ArpitAwasthi2411/slam-robot/hardware/datasheets/links.md

# Datasheets & references

- RPLiDAR A1: https://www.slamtec.com/en/Lidar/A1
- ESP32-S3: https://www.espressif.com/en/products/socs/esp32-s3
- BTS7960 driver: add the link for your module
