ArpitAwasthi2411/slam-robot/docs/navigation.md

# Navigation app: places, routes, missions, commands

Everything here runs on the Pi with **no internet and no Nav2 install**. It's built into the
`navigator` node, which `bringup.launch.py` starts by default (`nav_mode:=planner`).

Dashboard: route preview, queued mission, places

## The workflow (once encoder odometry is calibrated)

### 1. Map the floor once
```bash
ros2 launch lidar_robot bringup.launch.py
```
- Drive slowly around the whole floor with RC or the dashboard joystick, and come back to the
  start (loop closure).
- Dashboard → **Status → Save map**, name it e.g. `cse_floor`. You get:
  - `~/maps/cse_floor.pgm` + `.yaml`: an image of the map, which can also be used with Nav2's map_server
  - `~/maps/cse_floor.pbstream`: Cartographer's full state, needed for step 2

### 2. Every run after that: localise on the saved map
```bash
ros2 launch lidar_robot bringup.launch.py slam_mode:=localization map:=~/maps/cse_floor.pbstream
```
- Start the robot roughly where mapping started. Drive a metre or two.
- Check that the red scan points sit on the black walls of the map, then press **Position OK**.
  The navigator refuses to drive until you do: a wrong pose means a wrong route.
- Why this matters: a fresh mapping run starts a new map frame, so saved places would point at the
  wrong spots. Localization keeps the same frame every run.

### 3. Teach it places
- Drive to the HOD office door, then **Go → Places → Save here** and type `HOD office`, with
  aliases `hod, head of department`.
- Or **Add place** on the map: click the spot and drag to set the direction the robot should face.
- Places are saved in `~/maps/places.json` (one file per saved map; copy it next to the
  `.pbstream` when you back up the map).
- **Set home** marks the parking spot. "Go home" and the command "come back" drive there.

### 4. Use it
| You do | Robot does |
|---|---|
| Search "hod" → **Route** | Shows the planned route (amber), its length and ETA. Nothing moves yet |
| **Go** (on the route card or a place) | Plans an A* route around walls, follows it, turns to the place's heading |
| **Go here** tool, then click the map | Shows a route preview first, then **Go** |
| RViz **2D Goal Pose** | Same planner, so RViz goals now go around walls too |
| Type "urgent: take this to the HOD office then lab 3" | Parses the command, then queues a 2-stop mission at priority 3, which pauses the current normal one |
| Something blocks the corridor | Slows down, stops at 38 cm, waits 2 s, plans a new route around it (max 3 times), then fails with a reason |
| E-stop | Missions pause. After release they stay on **HOLD** until you press **Resume** |
| Touch the joystick or RC | Manual always wins, and the current mission is canceled |

## Commands: LLM with an offline fallback

- **With internet** (Pi on Wi-Fi): `export GROQ_API_KEY=gsk_...` before `ros2 launch`. The navigator
  sends the command plus the list of known places to Groq and gets back
  `{intent, targets, priority, reply}`.
- **Without internet, or if the LLM call fails**: a built-in rule parser handles
  "go to / take / deliver ... then ...", typos ("principl offce"), urgency words, "come back", "stop"
  and "where are you". The dashboard marks each answer **LLM** or **OFFLINE**.
- **Hallucination guard**: any place the LLM names that isn't on the map is dropped and reported,
  never driven to.

That fallback, plus the guard, is your answer to the ELLMER limitation ("cloud-dependent with no
fallback").

## Failure reasons (foundation for LLM error recovery)

Every failed mission records a code and a sentence, shown in the dashboard and the activity log:

| Code | Meaning | Typical recovery |
|---|---|---|
| `GOAL_IN_OBSTACLE` | target is inside a wall or furniture | move the place, or pick the nearest free spot |
| `OUTSIDE_MAP` | target outside the mapped area | map that area first |
| `NO_PATH` | no free route (door closed or unexplored) | try later, or another route/entrance |
| `BLOCKED` | something stayed in the way after 3 new routes | ask a human, wait, or skip the stop |
| `START_BLOCKED` | robot too close to an obstacle to plan | back off 30 cm |
| `POSE_LOST` | SLAM pose stale for over 3 s | stop, relocalize |
| `INTERNAL` | software error (logged with a traceback) | report |

Phase 7 idea: feed `{code, text, mission, places, time}` to the LLM and let it choose among a fixed set
of safe actions (retry later / skip stop / reorder stops / notify user / go home), each validated
before running. Same pattern as the command parser: the LLM proposes, the code checks.

## Request API (for the app, scripts, and your FastAPI server)

Send a JSON `std_msgs/String` to `/navigator/request`; replies arrive on `/navigator/response`. Over
HTTP, the dashboard forwards `POST /api/nav` with the same JSON.

```jsonc
{"type": "goto_place", "name": "HOD office", "priority": 1}
{"type": "goto_pose", "x": 3.2, "y": 1.0, "yaw": 1.57, "label": "lab door"}
{"type": "command", "text": "urgent take this to hod then lab 3"}
{"type": "preview", "name": "Lab 3"}             // route only, no motion
{"type": "cancel"}  {"type": "cancel", "id": 7}
{"type": "resume"}  {"type": "go_home"}  {"type": "confirm_localization"}
{"type": "add_place", "name": "Lab 3", "x": 2.2, "y": 1.8, "yaw": -1.57, "aliases": ["computer lab"]}
{"type": "add_place", "name": "Water cooler", "here": true}
{"type": "delete_place", "name": "Lab 3"}   {"type": "set_home", "here": true}
{"type": "search", "q": "hod"}
// routes, patrols and drawn paths (app map tools)
{"type": "goto_poses", "waypoints": [{"x": 1, "y": 2}, {"x": 3, "y": 2, "label": "door"}], "repeat": -1}  // -1 = patrol
{"type": "check_path", "points": [[0, 0], [1, 0.5], [2, 0.5]]}      // drawn path: length, ETA, too-close parts
{"type": "follow_path", "points": [[0, 0], [1, 0.5], [2, 0.5]], "repeat": 0, "allow_close": false}
// exploration (docs/exploration.md) and path-follower tuning (Tuning Lab)
{"type": "explore_start", "speed": 0.18, "turn_speed": 0.45, "scan_spin": true}   {"type": "explore_stop"}
{"type": "get_tune"}   {"type": "tune", "follower": {"lookahead": 0.5}, "save": true}
// rooms, dock, schedules, "wait for OK", explain, mission log: see "v2.4: tasks people actually ask for" below
{"type": "recovery_answer", "id": 3, "choice": "retry"}   // answer "ask a person" (docs/recovery.md)
```
The full list with every field is at the top of `lidar_robot/navigator_core.py`; which role may send which
type is `STAFF_NAV` in `lidar_robot/auth.py` (staff: go/call/stop/ask, operator: everything else).

Status (4 Hz, `/navigator/status`): state, message, goal, remaining route, distance, ETA, missions
(active, queue, history), recent events, hold, localized.

Command-line example:
```bash
ros2 topic pub --once /navigator/request std_msgs/msg/String '{data: "{\"type\": \"goto_place\", \"name\": \"Lab 3\"}"}'
ros2 topic echo /navigator/status --once
```

## Tuning (`config/robot_params.yaml` → `navigator:`)
| Param | Default | What it does |
|---|---|---|
| `robot_radius` | 0.27 m | keep-out radius. Your corridor is 0.88 m wide, so 0.88 − 2×0.27 leaves 0.34 m of usable centre line |
| `soft_radius` | 0.60 m | prefer this much clearance from walls (keeps to the corridor centre) |
| `max_linear` | 0.22 m/s | cruise speed |
| `stop_distance` | 0.38 m | front clearance from the robot centre that stops it (440 mm chassis) |
| `blocked_after` | 5 s | stopped by an obstacle this long → plan a route around it (people usually move by then) |
| `us_memory_s` | 60 s | an obstacle only the ultrasonics see (low box, chair legs: below the LiDAR plane) is kept on the plan this long. While the robot is blocked, and for 15 s while it goes round, every sensor's echoes are placed along that sensor's own ~30° beam (left / centre / right), so the obstacle lands on the side where it really is and the planner goes round the free side (log: `ultrasonic blocker on the right remembered`). Each echo is grown 0.3 m deep plus a 0.15 m berth; echoes on mapped walls are skipped (corridors stay usable); after 60 s it is forgotten so a moved box leaves no fake wall |
| `dwell_s` | 3 s | wait at intermediate stops |
| `auto_return_s` | 0 | above 0: drive home after this many idle seconds |
| `allow_unknown` | false | plan only through mapped free space |

## Try it without the robot
```bash
python3 tools/dashboard_sim.py      # simulated CSE floor, same navigator code
# open http://localhost:8080
```

## v2.4: the robot knows its own shape

The planner used to treat the robot as a 27 cm circle around the drive axle. Ours is a 44 × 42 cm
rectangle with the axle near the **front**, so the back (37 cm behind the axle) swung out on turns
and clipped walls. Now:

- **Measure and set** `footprint_front`, `footprint_rear`, `footprint_half_width` in
  `config/robot_params.yaml` (axle centre → front bumper, → back edge, centre line → side).
  The app draws exactly this rectangle, so check it lines up with the scan dots around the robot.
- **Planning:** every route is checked with the whole rectangle at every point and at every turn
  on the spot. If it clips, it tries a wider route (one that clears the full turning circle). If no
  wider route exists (a narrow door), it keeps the route but marks the tight spots (orange rings in
  the app) and drives them at 60 % speed.
- **Driving:** every 50 ms the live 360° scan is checked against the body:
  - a turn on the spot that would swing the back into something is refused; it turns the other way
    round if that is clear, otherwise it plans a short **3-point turn** (pull ahead / back out a few
    cm / turn) that ends facing the route;
  - on curves, if the body would touch something within 0.6 s it straightens or stops;
  - near anything (doors) it slows down in proportion to the gap.
- **Result in the simulator** (`python3 tools/eval_nav.py`, same layout as the sim, 12 missions incl.
  4 hard starts next to walls):

  | | reached | wall contacts | total time |
  |---|---|---|---|
  | old (circle robot) | 10 / 12 | 3 | 986 s |
  | v2.4 body checks | **12 / 12** | **0** | 582 s |

## v2.4: tasks people actually ask for

- **Wait for OK:** "take this file to the HOD office and wait for a signature, then Lab 2". At that
  stop the app shows a big **OK, carry on** card (and the robot says so). It carries on by itself
  after `confirm_timeout_s` (5 min). Saying "ok" / "done" by voice works too.
- **Rooms:** Room tool → drag a box over a room → name it and list what is in it. Then: "take me to
  the 3D printer", "where is the oscilloscope?", "go to the room with the soldering station".
  The robot drives to the room's centre, or to a saved place with the same name (put a place at
  the door for rooms with furniture in the middle). The app shows which room the robot is in.
- **Schedule:** Go tab → Schedule → Add: a place, home, charge or any command at a time, every
  day or chosen days. Uses the Pi's clock (set by NTP when it has internet; after a power cut
  without internet, set it once with `sudo date -s "2026-10-14 09:30"`).
- **Why did you stop?** Tap the state chip at the top right (or say "why did you stop?"). The
  answer comes from the navigator's own state and log: e-stop, waiting for OK, blocked in front,
  no room to turn, failure reasons, battery.
- **Mission log:** every finished mission is a line in `~/maps/missions.jsonl` (time, distance driven
  vs planned, replans, blocked time, bumps, e-stops, closest approach to anything). Lab → Log shows
  success rate, average time and speed, path efficiency; Export CSV for the report.
- **AI assistant access:** [mcp.md](mcp.md).

New request types (JSON on `/navigator/request` or `POST /api/nav`): `confirm`, `explain`, `find`,
`add_room`, `update_room`, `delete_room`, `goto_room`, `set_dock`, `go_dock`, `schedule_add`,
`schedule_delete`, `schedule_enable`, `schedule_list`, `mission_log`. See the top of
`navigator_core.py`.

## Error recovery (Phase 3)

When a step fails with a recoverable reason code the navigator no longer just marks the mission FAILED: it
stops (state `RECOVERING`), the LLM or the rule-based fallback picks one action from a fixed menu (wait and
retry, wider route, detour, skip the stop, do it later, ask a person, go home, go to the dock) and the robot
carries it out. `status()['recovery']` drives the app's "What happened / What I'm doing" card. Details,
settings and the evaluation: [recovery.md](recovery.md).

## Person or object in the way (`blockers.py`)

When the front is blocked the robot first decides what blocks it, using the people detector (the Pi camera,
or the mounted phone in head mode) together with the LiDAR / ultrasonic stop:

| In the way | How it knows | What it does |
|---|---|---|
| a person | the detector reports someone in the path within 2.5 m while the front is blocked | stops, says "Excuse me, may I pass?" once, waits `person_wait_s` (8 s). Way clear: "Thank you", continues. Still there: looks for another route |
| an object | fresh camera decisions, nobody in the path for `object_wait_s` (1.2 s) | says nothing, looks for another route at once (before: always waited `blocked_after`, 5 s) |
| unknown | no fresh camera decision (camera off, detector resting, no picture) | as before: asks to make way, replans after `blocked_after` |

- The decision is taken over about a second, not on one frame. A person seen once stays "a person" for that block.
- Wrong guesses are safe: the robot never drives through anything; it only chooses between waiting and going around.
- A camera STOP (person very close) still holds the robot by itself, as before.
- The app message, "Why did you stop?" and the head-mode face say which it is.
- Each trip in the mission log counts `blocked_person` and `blocked_object`; `/navigator/status` → `blocker`
  has the totals and the seconds lost to each, for the reliability table.
- Settings (navigator): `polite_pass` (false = old behaviour), `person_wait_s`, `object_wait_s`, `pass_text`
  (e.g. "Kripya raasta dijiye").

Not yet tried on the robot: check that the person check agrees with what you see (stand in the path: it must
ask; put a chair there: it must reroute without speaking).
