ArpitAwasthi2411/slam-robot/docs/REVIEW_2026-10.md

# Repo review, October 2026 (Phase 0)

Scope: firmware (3 sketches), ROS package (nodes + pure-Python logic), launch/config, the app and the classic
page, scripts, tools, docs and CI. Method: read the core modules (navigator_core, esp32_bridge, dashboard,
dashboard_server, auth, navigator, explain, mapsave, mcp_server), automated checks over everything
(pyflakes on all Python, `bash -n` + shellcheck on all scripts, YAML params vs. the parameters each node
declares/reads, every API path and navigator request type used by each client vs. what the server/core
implements, firmware `#define` pins vs. every pin table in the docs, test coverage per module), and ran the
tools (`dashboard_sim.py`, `eval_nav.py`, `eval_commands.py`, the MCP server against the simulator).

Tests: 112 → **126** (125 + 1 skip under the CI's Python 3.10 / pytest 6.2.5). Coverage of the pure-Python
logic 65 % → 71 %. The four ROS node wrappers (navigator, dashboard, goal_controller, us_listener) have no
unit tests: they are thin and need TF/rclpy; the bridge is covered end to end over a pseudo-terminal.

## Bugs fixed

| # | Where | What was wrong | Fix + test |
|---|---|---|---|
| 1 | `dashboard_server.py`, `dashboard.py`, `esp32_bridge.py` | `POST /api/cmd {"v": "nan"}` passed `float('nan')` through the `min/max` clamp (NaN compares false) into `/cmd_vel_teleop`. In the bridge's 20 Hz timer `format_velocity` does `int(round(nan))` → `ValueError` inside an rclpy timer, which can take the bridge (motor link) down. Same for `inf` on the angular part and for `/api/goal`. | HTTP: `_num()` rejects non-finite numbers with 400. Dashboard: `command()` ignores non-finite. Bridge: `_on_cmd` drops non-finite twists from **any** publisher. `test_http_rejects_non_finite_drive_and_goal`, `test_non_finite_command_is_ignored_and_timer_survives` |
| 2 | `navigator_core._command` | The "stop" command cancelled missions but left **Map by itself** running: 2 s later the explorer queued a new frontier and the robot drove off again. | "stop" also ends exploration. `test_stop_command_also_ends_exploration` |
| 3 | `navigator_core._maybe_auto_home` | `_go_home` can raise (`battery critical`) inside `step()`; the node turns any exception from `step()` into an INTERNAL mission failure every tick. | caught + logged. `test_auto_home_never_crashes_the_loop` |
| 4 | `explain.py` | A failure code without a template (e.g. the node's `INTERNAL`) put the raw text through `str.format()`: any `{` in an exception message (dict/KeyError reprs) crashed "why did you stop?". | raw text is used as is. `test_explain_failure_text_with_braces` |
| 5 | `scripts/setup_ports.sh` | Written for two USB devices. With the ESP32-S3 on the GPIO UART (v2.6) step 2 waits for an ESP32 USB device that never comes, and the rules file it writes competes with `98-esp32-uart.rules` for `/dev/esp32`. | UART mode: if `98-esp32-uart.rules` exists (or `ESP32_LINK=uart`) it only names the LiDAR and never writes an esp32 USB rule. |
| 6 | `tools/serial_probe.py` | Speeds computed with `TICKS_PER_REV = 4740`; the firmware and `robot_params.yaml` use ~4970 (measured): every mm/s it printed was ~5 % high. It also told you to edit the legacy sketch. | 4970; points to `robot_esp32s3` / `robot_esp32_classic`. |
| 7a | `tools/dashboard_sim.py` | The simulator resets its data in the repo's `maps/` folder at every start, so running it from a test deleted the tracked `maps/sim/schedules.json`. | `SimBackend(data_dir=...)`; tests use a temporary folder (the CLI keeps the old default). |
| 7 | `deploy/docker/entrypoint.sh` | Malformed shellcheck directive (comment text on the directive line; shellcheck error SC1125). | directive on its own line. |

## Mismatches between code and docs fixed

| Where | Was | Now (matches the sketch) |
|---|---|---|
| `hardware/README.md` pin table, S3 column | the old v2.2 auto pin map: motors 5/6/9/10, RC 4/7, IMU 1/2, e-stop 41, echo 38/39/40, link `/dev/ttyACM0` | v2.6: motors 4/5/6/7, RC 10/9, IMU 11/12, e-stop 42, echo 39/40/41, UART 47/8 → `/dev/ttyAMA0`, battery 1, bumper 2, LED 48 |
| `hardware/README.md` + `wiring_classic_esp32.md`, classic RC | steering 34, throttle 35 | steering **35**, throttle **34** (`RC_STEERING_PIN 35`, measured 2026-10-07) |
| `wiring_classic_esp32.md` | "Free for later: 36, 39" | 36 = battery divider, 39 = bumpers (v2.4) |
| `hardware/sensors.md` | S3 pins "SDA 1, SCL 2, e-stop 41, ECHO 38/39/40" | SDA 11, SCL 12, e-stop 42, ECHO 39/40/41 |
| README, hardware/README | 4740 ticks/rev, "ESP32 USB serial", `firmware/robot_esp32/` as the sketch | ~4970, GPIO UART (S3) / USB (classic), the two current sketches; `firmware/robot_esp32/` marked legacy v2.2 |
| README status | stopped at v2.4 "flash firmware v2.4" | what is verified on the robot vs. done in code only |
| `docs/roadmap.md` | "The dashboard has no login" | logins with roles since the auth work; note on HTTP vs Tailscale vs Funnel |
| `docs/deploy.md`, `docs/calibration.md` | flash/edit `firmware/robot_esp32/robot_esp32.ino` (v2.2) | `robot_esp32s3` (v2.6) or `robot_esp32_classic` (v2.4) |
| `docs/STEPS_esp32s3_lab.md`, `docs/START_TODAY.md` | Pathik-11 / Pathik-4 APK | "the latest Pathik-N.apk from Releases" (v1.0.12 is current) |
| `docs/navigation.md`, `navigator_core.py` docstring | request API without `goto_poses`, `check_path`, `follow_path`, `explore_*`, `get_tune`, `tune` | listed, plus where the role rules live |
| `docs/troubleshooting.md` | only USB link problems | row for the GPIO UART link |

## Checked and fine

- Every key in `robot_params.yaml` is declared by its node (the goal_controller ones come from the
  `GoalParams` dataclass), and every declared parameter is read.
- Every `/api/...` path the app, the classic page and the MCP server call exists in `dashboard_server.py`;
  every navigator request type the app sends is handled by `NavigatorCore.handle`.
- S3 sketch pins = `CONNECTIONS_esp32s3.md` = `wiring_esp32s3.md` (checked line by line).
- pyflakes clean on all Python; `bash -n` clean on all scripts; shellcheck: no errors left.
- MCP server works against the simulator with a staff login and says what is missing without one (new
  end-to-end test `test_mcp_server.py`, skipped inside the Docker image which has only the ROS package).
- Map names are sanitised (`safe_name`): no path traversal through "Save map".
- `tools/eval_nav.py`: 12/12 reached, 0 wall contacts with body checks (3 without). `eval_commands.py`
  offline rules: 27/30 (90 %).

## Found, left for a later phase (with the reason)

| What | Why not now | Phase |
|---|---|---|
| ~~Login rate limit is per (username, address). Behind Tailscale Funnel every request comes from 127.0.0.1, and the failure table / sign-ups are unbounded.~~ **Done in Phase 1**: real client address from Funnel's X-Forwarded-For, per-address + per-account limits, pruned tables, sign-up cap. | belongs with the public-HTTPS work | 1 |
| ~~The mobile app cannot delete a saved place.~~ **Done in Phase 2** (Send → Route → Delete place, operator). | the redesign adds it (features may only be added) | 2 |
| ~~Android `setTextZoom(100)` ignores the phone's font-size setting.~~ **Done in Phase 2** (follows it up to 130 %). | the redesign must survive larger text first | 2 |
| ~~`_docking` reverses onto the dock.~~ **Done in Phase 4**: front docking with the marker (`docs/docking.md`). | it is Phase 4 | 4 |
| ~~Firmware comments still mention "4740 ticks/rev"; no I2C scan.~~ **Done in Phase 4** (v2.7 / v2.5: `I` scan, boot scan, comments fixed). | firmware is touched (and CI-checked) once, in Phase 4 | 4 |
| ~~`speech.py` uses espeak.~~ **Done in Phase 5**: Piper (offline, EN + HI), espeak fallback, one queue, rate limit. | Phase 5 (Piper) | 5 |
| ~~Static TF publishers in the launch, no camera frame.~~ **Done in Phase 6**: Xacro URDF + robot_state_publisher, camera frames added. | Phase 6 (URDF) | 6 |
| Offline rule parser misses 3/30 test sentences ("is anything wrong" → explain). | it is the fallback; the LLM handles them | – |

## Found later (fixed in Phase 5)

| What | Fix |
|---|---|
| `deploy/pi/docker-compose.yml` had no cgroup rule for `/dev/ttyAMA0` (the ESP32-S3 on the GPIO UART since 28 Oct): the Docker deployment could not reach the motor board | `c 204:* rmw` added (and `c 254:*` for the push-to-talk GPIO) |

## Still needs the robot

- Everything above that touches hardware behaviour: the NaN guard on a real ESP32, `setup_ports.sh` in UART
  mode on the Pi, the corrected classic RC pins (only matters if the classic board is used again).
- The open items from before: IMU on the S3 (B2), footprint + wheel separation (B3), camera setup (B4).
