ArpitAwasthi2411/slam-robot/ros2_ws/src/lidar_robot/lidar_robot/navigator.py

#!/usr/bin/env python3
"""Navigator node: named places + A* path planning + path following + mission queue.

Replaces goal_controller when bringup runs with nav_mode:=planner (the default).

Subscribes  /map                  nav_msgs/OccupancyGrid
            /scan                 sensor_msgs/LaserScan   (obstacle stop + replanning around new obstacles)
            /goal_pose            geometry_msgs/PoseStamped (RViz 2D Goal Pose -> planned route)
            /goal_cancel          std_msgs/Empty
            /estop                std_msgs/Bool
            /navigator/request    std_msgs/String  JSON request (see navigator_core.py)
            /vision/decision      std_msgs/String  camera people decision (vision_node)
            /vision/dock_marker   std_msgs/String  dock marker pose (vision_node, marker_pose.detect format)
Publishes (also) /vision/marker_request  std_msgs/Empty  while docking: the camera looks for the marker only then
Publishes   /cmd_vel              geometry_msgs/Twist
            /plan                 nav_msgs/Path    current route (RViz: add Path display)
            /navigator/status     std_msgs/String  JSON, 4 Hz
            /navigator/places     std_msgs/String  JSON, latched, on change
            /navigator/response   std_msgs/String  JSON replies to requests ({"req_id": ...})
            /dock_mode            std_msgs/Bool    True while creeping onto the dock (the bridge sends D,1)

Optional: export GROQ_API_KEY=... before launching for LLM command parsing (needs internet).
Without it (or offline) the built-in rule parser is used.
"""
import hashlib
import json
import math
import os
import threading
import time
import traceback

import rclpy
from rclpy.node import Node
from rclpy.qos import QoSProfile, DurabilityPolicy, ReliabilityPolicy, qos_profile_sensor_data
from rclpy.time import Time
from geometry_msgs.msg import PoseStamped, Twist
from nav_msgs.msg import OccupancyGrid, Path
from sensor_msgs.msg import LaserScan
from std_msgs.msg import Bool, Empty, String
from tf2_ros import Buffer, TransformListener, TransformException

from lidar_robot.commands import CommandParser
from lidar_robot.llm import GroqClient, LLMLog, clean_key
from lidar_robot.blockers import BlockerWatch
from lidar_robot.chat import ChatAgent
from lidar_robot.knowledge import Knowledge
from lidar_robot.recovery import Recovery, RecoveryLLM
from lidar_robot.docking import DockParams
from lidar_robot.battery import BatteryMonitor
from lidar_robot.follower import FollowerParams
from lidar_robot.footprint import Footprint
from lidar_robot.speech import Speaker
from lidar_robot.kinematics import compose_2d, yaw_from_quaternion
from lidar_robot.navigator_core import NavigatorCore
from lidar_robot.netcheck import network_ok
from lidar_robot.places import PlaceStore
from lidar_robot import scan_points
from lidar_robot.planner import GridMap, Planner, PlannerParams
from lidar_robot.sensors import to_world
from lidar_robot.us_listener import UltrasonicListener
from lidar_robot.vision_rules import VisionGate


class NavigatorNode(Node):
    def __init__(self):
        super().__init__('navigator')
        d = self.declare_parameter
        d('global_frame', 'map')
        d('base_frame', 'base_link')
        d('places_file', os.path.expanduser('~/maps/places.json'))
        d('rate', 20.0)
        d('robot_radius', 0.27)
        d('soft_radius', 0.60)
        d('allow_unknown', False)
        d('max_linear', 0.22)
        d('max_angular', 0.6)
        d('lookahead', 0.50)
        d('k_angular', 1.0)
        d('linear_accel', 0.3)
        d('angular_accel', 1.2)
        d('rotate_in_place_above', 1.2)
        d('rotate_exit_below', 0.30)
        d('stop_distance', 0.38)
        d('slow_distance', 0.80)
        d('blocked_after', 5.0)            # s stopped by an obstacle before planning around it
        d('us_memory_s', 60.0)             # s an ultrasonic-only blocker stays on the plan
        d('robot_half_width', 0.25)
        # the body: a rectangle around the drive axle (base_link). MEASURE YOUR ROBOT:
        d('footprint_front', 0.07)         # axle -> front bumper (m)
        d('footprint_rear', 0.37)          # axle -> back edge (m)
        d('footprint_half_width', 0.21)    # centre line -> side (m)
        d('footprint_margin', 0.04)        # extra keep-out (m)
        d('battery_cells', 3)
        d('battery_low_pct', 25)
        d('battery_critical_pct', 12)
        d('confirm_timeout_s', 300.0)      # "wait for OK" stops give up after this
        d('dock_offset', 0.55)             # reverse docking only: m in front of the dock where the reverse starts
        d('dock_direction', 'front')       # front: nose-first onto the contacts, guided by the marker (docking.py)
        d('dock_predock_m', 0.60)          # pre-dock pose this far in front of the docked pose
        d('dock_contact_dist_m', 0.10)     # base_link to the marker plane when docked
        d('dock_creep_speed', 0.04)        # m/s (capped at 0.05)
        d('dock_tries', 3)
        d('dock_backoff_m', 0.25)
        d('dock_volt_rise', 0.15)          # V: counts as contact when there is no current sensor
        d('dock_without_marker', False)    # true = dock on the map pose alone (no camera; less precise)
        d('camera_x', 0.05)                # camera position in base_link (m) and height (m)
        d('camera_y', 0.0)
        d('camera_z', 0.20)
        d('front_cone_deg', 25.0)
        d('dwell_s', 3.0)
        d('speech', True)                  # speak through a speaker on the Pi (needs espeak-ng)
        d('speech_voice', 'en-in')        # espeak voice (fallback when Piper is not installed)
        d('speech_engine', 'auto')         # auto (Piper, else espeak) | piper | espeak
        d('speech_volume', 1.0)            # 0 .. 1.5
        d('speech_voice_en', '')           # Piper voice .onnx ('' = first ~/piper/voices/en_*.onnx)
        d('speech_voice_hi', '')           # Hindi voice ('' = first ~/piper/voices/hi_*.onnx)
        d('speech_max_per_min', 8)         # rate limit (questions to people, battery always get through)
        d('speech_device', '')             # ALSA output device ('' = default)
        d('auto_return_s', 0.0)
        d('button_enabled', True)          # voice button on the robot (admins can switch it off in the app)
        d('button_home_radius', 0.6)       # m: trips from the button only start this close to Home / the dock
        d('button_gap_s', 30.0)            # one voice trip from the button per this many seconds
        d('offline_home_s', 120.0)         # no network this long and nothing to do -> wait at home (0 = never)
        d('network_check_s', 10.0)
        d('max_replans', 3)
        d('pose_timeout', 1.0)          # wheel odometry (odom->base_link) older than this = position lost
        d('map_tf_timeout', 10.0)       # SLAM's map->odom correction may lag this much (it changes slowly)
        d('odom_frame', 'odom')
        d('require_localization_confirm', False)   # bringup sets true in slam_mode:=localization
        d('llm_model', 'openai/gpt-oss-20b')   # Groq; retired names are mapped to a current model (llm.py)
        d('llm_policy', 'smart')        # smart: rules first, LLM only when unsure | always | off
        d('llm_timeout', 6.0)
        d('recovery_mode', 'llm')       # llm (LLM first, rules if no key/network) | rules | off (old behaviour)
        d('recovery_llm_model', 'openai/gpt-oss-120b')
        d('polite_pass', True)          # blocked by a person: ask and wait; by an object: reroute at once (blockers.py)
        d('person_wait_s', 8.0)         # how long a person gets to step aside before a new route
        d('object_wait_s', 1.2)         # nobody in view this long = an object
        d('pass_text', 'Excuse me, may I pass?')
        d('nav_backend', 'pathik')      # pathik = own A* + follower | nav2 = Nav2 plans and drives (nav2_follower.py)
        d('nav2_mode', 'navigate')      # navigate = Nav2 planner + controller | follow = Pathik's route, Nav2 controller
        d('nav2_cmd_topic', 'cmd_vel_nav2')
        d('chat_enabled', True)         # talk to the robot: college notebook + general questions (chat.py)
        d('chat_model', 'openai/gpt-oss-120b')   # the bigger model converses and follows the rules better
        d('knowledge_file', '')         # '' = knowledge.json next to places.json
        d('recovery_max_per_mission', 4)
        d('recovery_ask_timeout_s', 120.0)
        d('use_vision', True)           # camera people detection may slow / stop autonomous driving
        d('vision_timeout', 1.0)        # s: an older camera decision is ignored
        g = lambda n: self.get_parameter(n).value  # noqa: E731

        self.global_frame = g('global_frame')
        self.base_frame = g('base_frame')
        self.half_width = float(g('robot_half_width'))
        self.cone = math.radians(float(g('front_cone_deg')))
        self.pose_timeout = float(g('pose_timeout'))
        self.map_tf_timeout = float(g('map_tf_timeout'))
        self._last_corr = None           # last map->odom correction: a sudden change = the map 'jumped'
        self._corr_jumps = []
        self.odom_frame = g('odom_frame')

        self.places = PlaceStore(g('places_file'))
        key = clean_key(os.environ.get('GROQ_API_KEY'))
        self.llm_log = LLMLog()                  # every LLM call + its exact error, shown in the app
        parser = CommandParser(self.places, groq_api_key=key, model=str(g('llm_model')),
                               timeout=float(g('llm_timeout')), policy=str(g('llm_policy')), log=self.llm_log)
        self.parser = parser
        kfile = str(g('knowledge_file')) or os.path.join(os.path.dirname(g('places_file')), 'knowledge.json')
        self.knowledge = Knowledge(kfile)
        self.chat = ChatAgent(GroqClient(key, model=str(g('chat_model')), timeout=float(g('llm_timeout')) + 2.0,
                                         log=self.llm_log),
                              self.knowledge, self.places, enabled=bool(g('chat_enabled')))
        self.planner_params = PlannerParams(robot_radius=float(g('robot_radius')),
                                            soft_radius=float(g('soft_radius')),
                                            allow_unknown=bool(g('allow_unknown')))
        self.speaker = Speaker(enabled=bool(g('speech')), voice=str(g('speech_voice')), engine=str(g('speech_engine')),
                               volume=float(g('speech_volume')), voice_en=str(g('speech_voice_en')),
                               voice_hi=str(g('speech_voice_hi')), max_per_min=int(g('speech_max_per_min')),
                               audio_device=str(g('speech_device')))
        if self.speaker.enabled and not self.speaker.available:
            self.get_logger().info('robot voice off: run scripts/setup_voice.sh (Piper) or install espeak-ng, '
                                   'and connect a speaker')
        else:
            self.get_logger().info(f'robot voice: {self.speaker.engine}, volume {self.speaker.volume:.1f}')
        self.create_subscription(String, 'speech/say', self._on_say, 10)
        self.core = NavigatorCore(
            self.places,
            self.planner_params,
            FollowerParams(max_linear=float(g('max_linear')), max_angular=float(g('max_angular')),
                           lookahead=float(g('lookahead')), k_angular=float(g('k_angular')),
                           linear_accel=float(g('linear_accel')), angular_accel=float(g('angular_accel')),
                           rotate_in_place_above=float(g('rotate_in_place_above')),
                           rotate_exit_below=float(g('rotate_exit_below')),
                           stop_distance=float(g('stop_distance')), slow_distance=float(g('slow_distance')),
                           blocked_after=float(g('blocked_after'))),
            parser=parser, dwell_s=float(g('dwell_s')), auto_return_s=float(g('auto_return_s')),
            max_replans=int(g('max_replans')),
            tuning_path=os.path.join(os.path.dirname(g('places_file')), 'tuning.json'),
            footprint=Footprint(float(g('footprint_front')), float(g('footprint_rear')),
                                float(g('footprint_half_width')), float(g('footprint_margin'))),
            battery=BatteryMonitor(cells=int(g('battery_cells')), low_pct=float(g('battery_low_pct')),
                                   critical_pct=float(g('battery_critical_pct'))),
            confirm_timeout_s=float(g('confirm_timeout_s')), dock_offset=float(g('dock_offset')),
            dock_front=str(g('dock_direction')) != 'reverse', dock_without_marker=bool(g('dock_without_marker')),
            dock_params=DockParams(predock_m=float(g('dock_predock_m')), contact_dist_m=float(g('dock_contact_dist_m')),
                                   creep_speed=min(0.05, float(g('dock_creep_speed'))), tries=int(g('dock_tries')),
                                   backoff_m=float(g('dock_backoff_m')), volt_rise=float(g('dock_volt_rise')),
                                   cam_x=float(g('camera_x')), cam_y=float(g('camera_y')), cam_z=float(g('camera_z'))),
            recovery=Recovery(llm=RecoveryLLM(key, model=str(g('recovery_llm_model')), log=self.llm_log),
                              mode=str(g('recovery_mode')),
                              max_per_mission=int(g('recovery_max_per_mission')),
                              ask_timeout_s=float(g('recovery_ask_timeout_s'))),
            knowledge=self.knowledge, chat=self.chat,
            blockers=BlockerWatch(enabled=bool(g('polite_pass')), person_wait_s=float(g('person_wait_s')),
                                  object_wait_s=float(g('object_wait_s')), ask_text=str(g('pass_text'))),
            button_enabled=bool(g('button_enabled')), button_home_radius=float(g('button_home_radius')),
            button_gap_s=float(g('button_gap_s')), offline_home_s=float(g('offline_home_s')))
        self.core.localized = not bool(g('require_localization_confirm'))
        self.core.us_memory_s = float(g('us_memory_s'))
        self.vision = VisionGate(enabled=bool(g('use_vision')), timeout_s=float(g('vision_timeout')))
        self.create_subscription(String, 'vision/decision', self._on_vision, 10)
        self.create_subscription(String, 'vision/dock_marker', self._on_marker, 10)
        self.core_lock = threading.RLock()       # callbacks + map worker thread share the core
        self.topic_estop = False
        self.bridge_estop = False
        self.map_hash = None
        self.map_job = None                      # latest map waiting for the worker
        self.map_event = threading.Event()
        threading.Thread(target=self._map_worker, daemon=True).start()

        self.tf_buffer = Buffer()
        self.tf_listener = TransformListener(self.tf_buffer, self, spin_thread=True)
        self.us = UltrasonicListener(self, self.tf_buffer, self.base_frame)   # low obstacles (v2.2)
        self.front = float('inf')
        self.scan_stamp = None
        self.laser_tf = None
        self.map_stamp = None
        self.places_version_sent = -1
        self.last_plan_sent = None
        self._was_active = False
        self._vision_said = ''

        latched = QoSProfile(depth=1, durability=DurabilityPolicy.TRANSIENT_LOCAL,
                             reliability=ReliabilityPolicy.RELIABLE)
        volatile = QoSProfile(depth=1, durability=DurabilityPolicy.VOLATILE,
                              reliability=ReliabilityPolicy.RELIABLE)
        self.cmd_pub = self.create_publisher(Twist, 'cmd_vel', 10)
        self.nav_backend = str(g('nav_backend'))
        # with Nav2 the topic 'plan' is Nav2's own route; ours (used for the checks) moves aside
        self.plan_pub = self.create_publisher(Path, 'navigator/plan' if self.nav_backend == 'nav2' else 'plan', 1)
        self.status_pub = self.create_publisher(String, 'navigator/status', 5)
        self.places_pub = self.create_publisher(String, 'navigator/places', latched)
        self.resp_pub = self.create_publisher(String, 'navigator/response', 10)
        self.dock_mode_pub = self.create_publisher(Bool, 'dock_mode', 10)     # ESP32 docking mode via the bridge
        self.marker_req_pub = self.create_publisher(Empty, 'vision/marker_request', 5)
        self.scan_geo = scan_points.ScanGeometry()

        self.create_subscription(OccupancyGrid, 'map', self._on_map, 1)
        self.create_subscription(LaserScan, 'scan', self._on_scan, qos_profile_sensor_data)
        self.create_subscription(PoseStamped, 'goal_pose', self._on_goal, 10)
        self.create_subscription(Empty, 'goal_cancel', self._on_cancel, 10)
        # latched + volatile: catch the dashboard's latched value AND plain `ros2 topic pub`
        self.create_subscription(Bool, 'estop', self._on_estop_topic, latched)
        self.create_subscription(Bool, 'estop', self._on_estop_topic, volatile)
        # the bridge also knows about e-stops latched inside the ESP32 (e.g. after a restart)
        self.create_subscription(String, 'robot/status', self._on_bridge_status, 10)
        self.create_subscription(String, 'navigator/request', self._on_request, 10)

        self.dt = 1.0 / float(g('rate'))
        if self.nav_backend == 'nav2':
            self._setup_nav2()
        self.create_timer(self.dt, self._tick)
        self.create_timer(0.25, self._publish_status)
        # network watch in a thread (one ping every network_check_s; never blocks the control loop)
        self._net_period = max(2.0, float(g('network_check_s')))
        threading.Thread(target=self._watch_network, daemon=True).start()
        self.get_logger().info(
            f'navigator ready: {len(self.places.places)} places from {g("places_file")}, '
            f'LLM {"ON (" + parser.model + ", policy " + parser.policy + ")" if key else "OFF (offline rule parser)"}, '
            f'error recovery {g("recovery_mode")}'
            + (f' ({self.core.rec.llm.model})' if key and g('recovery_mode') == 'llm' else
               ' (rules: no GROQ_API_KEY)' if g('recovery_mode') == 'llm' else ''))
        cfg = parser.client.config()
        if cfg['retired_model_replaced']:
            self.get_logger().warn(f'llm_model {cfg["requested_model"]} is retired on Groq: using {cfg["model"]}')
        if key and cfg['key_problem']:
            self.get_logger().warn(f'GROQ_API_KEY problem: {cfg["key_problem"]}')

    def _watch_network(self):
        while rclpy.ok():
            ok = network_ok()
            with self.core_lock:
                self.core.set_network(ok)
            time.sleep(self._net_period)

    # ---------------------------------------------------------------- inputs
    def _on_map(self, msg: OccupancyGrid):
        # Cartographer republishes /map every second even when nothing changed: skip those.
        i = msg.info
        o = i.origin.position
        raw = msg.data.tobytes() if hasattr(msg.data, 'tobytes') else bytes(b & 0xFF for b in msg.data)
        h = hashlib.blake2b(raw, digest_size=16)
        h.update(f'{i.width},{i.height},{i.resolution},{o.x:.3f},{o.y:.3f}'.encode())
        digest = h.digest()
        if digest == self.map_hash:
            return
        self.map_hash = digest
        self.map_job = (i.width, i.height, i.resolution, o.x, o.y, msg.data)
        self.map_event.set()

    def _map_worker(self):
        """Builds the costmap off the executor thread, then swaps it in (keeps the 20 Hz loop smooth)."""
        while rclpy.ok():
            if not self.map_event.wait(1.0):
                continue
            self.map_event.clear()
            job = self.map_job
            if job is None:
                continue
            try:
                planner = Planner(self.planner_params)
                grid = GridMap.from_occupancy(*job)
                planner.set_map(grid)
                with self.core_lock:
                    self.core.swap_planner(planner)
                    self.core.set_grid(grid)
                self.map_stamp = self.get_clock().now()
            except Exception as e:
                self.get_logger().error(f'map processing failed: {e}')

    def _on_cancel(self, _msg):
        with self.core_lock:
            self.core.handle({'type': 'cancel'})

    def _apply_estop(self):
        on = self.topic_estop or self.bridge_estop
        with self.core_lock:
            if on != self.core.estopped:
                self.core.set_estop(on)

    def _on_estop_topic(self, msg: Bool):
        self.topic_estop = bool(msg.data)
        self._apply_estop()

    def _on_bridge_status(self, msg: String):
        try:
            st = json.loads(msg.data)
            self.bridge_estop = bool(st.get('estop', False))
        except (ValueError, AttributeError):
            return
        self._apply_estop()
        bumps = int(st.get('bumps') or 0)
        if bumps > getattr(self, '_bumps_seen', bumps):
            with self.core_lock:
                self.core.note_bump()
        self._bumps_seen = bumps
        bat = st.get('battery') or {}
        if bat.get('v') is not None and bat.get('fresh', True):
            with self.core_lock:
                self.core.set_battery(float(bat['v']), bat.get('a'), bat.get('src', 'ina226'))

    def _on_scan(self, msg: LaserScan):
        if self.laser_tf is None:
            try:
                tf = self.tf_buffer.lookup_transform(self.base_frame, msg.header.frame_id, Time())
                r = tf.transform.rotation
                self.laser_tf = (tf.transform.translation.x, tf.transform.translation.y,
                                 yaw_from_quaternion(r.x, r.y, r.z, r.w))
            except TransformException:
                return
        lx, ly, lyaw = self.laser_tf
        laser = (lx, ly, lyaw)
        self.front = scan_points.front_clearance(
            self.scan_geo, msg.ranges, msg.angle_min, msg.angle_increment, msg.range_min, msg.range_max,
            laser=laser, half_angle=self.cone, robot_half_width=self.half_width)
        self.scan_stamp = self.get_clock().now()
        pose = self._pose()
        if pose:                                  # nearby scan points -> dynamic obstacles for replans
            pts, near = scan_points.obstacle_points(self.scan_geo, msg.ranges, msg.angle_min,
                                                    msg.angle_increment, msg.range_min, pose, laser=laser)
            us = self.us.points_base()
            pts += to_world(us, pose)                          # things below the LiDAR plane
            us_arc = to_world(self.us.arc_base(), pose)       # the whole beam, for the blocker memory
            with self.core_lock:
                self.core.update_scan_world(pts)
                self.core.update_us_world(us_arc)
                self.core.update_scan_base(near + list(us))

    def _on_goal(self, msg: PoseStamped):
        o = msg.pose.orientation
        with self.core_lock:
            self.core.handle({'type': 'goto_pose', 'x': msg.pose.position.x, 'y': msg.pose.position.y,
                              'yaw': yaw_from_quaternion(o.x, o.y, o.z, o.w), 'label': 'RViz goal',
                              'source': 'rviz'}, self._pose())

    def _on_say(self, msg: String):
        """Other nodes (voice replies) speak through this one speaker."""
        try:
            d = json.loads(msg.data)
        except ValueError:
            d = {'text': msg.data}
        self.speaker.say(str(d.get('text', ''))[:300], key=d.get('key') or None, gap_s=float(d.get('gap_s', 0.5)))

    def _on_request(self, msg: String):
        try:
            req = json.loads(msg.data)
        except ValueError:
            return
        if not isinstance(req, dict):
            return
        if req.get('type') in ('command', 'llm_test') and '_parsed' not in req:
            # The LLM call can take seconds: never inside the 20 Hz control loop or the core lock.
            threading.Thread(target=self._slow_request, args=(req,), daemon=True).start()
            return
        self._answer(req)

    def _slow_request(self, req):
        try:
            if req['type'] == 'llm_test':
                res = self._llm_test(req)
                res['req_id'] = req.get('req_id')
                self.resp_pub.publish(String(data=json.dumps(res)))
                return
            text = str(req.get('text', ''))
            who = 'robot button' if req.get('source') == 'button' else str(req.get('by') or '')[:32]
            pose = self._pose()
            with self.core_lock:                        # a few plain facts about the robot for the conversation
                ctx = self.core.chat_context(pose)
            parsed = self.chat.handle(text, self.parser, user=who, ctx=ctx)
            err = (parsed.get('llm') or {}).get('error')
            if err:
                self.get_logger().warn(f'LLM failed ({err["kind"]} {err.get("status") or ""}): '
                                       f'{err.get("detail", "")[:160]} -> offline parser. {err["hint"]}')
            req = dict(req, _parsed=parsed)
        except Exception as e:                          # parse() never raises, but be safe
            self.get_logger().error(f'LLM step failed: {e}')
            req = dict(req, _parsed=None)
        res = self._answer(req)
        try:                                            # plain commands join the talk too ("take me there" later)
            it = (res or {}).get('interpretation') or {}
            if it.get('intent') not in (None, 'chat', 'stop', 'refused') and not req.get('dry_run'):
                said = res.get('answer') or res.get('status') or it.get('reply')
                self.chat.remember('robot button' if req.get('source') == 'button' else str(req.get('by') or '')[:32],
                                   str(req.get('text', '')), str(said or ''))
        except Exception:
            pass

    def _llm_test(self, req):
        """App 'Test AI' button: key/network/model check, then one real command through the LLM."""
        d = self.parser.client.diagnose()
        sample = str(req.get('text') or 'take me to the first place on the map and then come back')
        if d['ok']:
            old = self.parser.policy
            self.parser.policy = 'always'
            self.parser._cache.clear()
            try:
                c = self.parser.parse(sample)
            finally:
                self.parser.policy = old
            info = c.get('llm') or {}
            d['sample'] = {'text': sample, 'intent': c['intent'], 'targets': c['targets'], 'source': c['source'],
                           'reply': c.get('reply'), 'ms': info.get('ms'), 'error': info.get('error')}
            if info.get('error'):
                d['ok'] = False
                d['summary'] = info['error']['hint']
            else:
                d['summary'] += f' Sample command understood in {info.get("ms")} ms.'
        self.llm_log.last_test = {'t': round(time.time(), 1), 'ok': d['ok'], 'summary': d['summary']}
        self.get_logger().info(f'LLM test: {d["summary"]}')
        return {'ok': True, 'test': d}

    def _answer(self, req):
        pose = self._pose()
        with self.core_lock:
            try:
                res = self.core.handle(req, pose)
            except Exception as e:                      # never let a request kill the node
                self.get_logger().error(f'request {req.get("type")} failed: {e}')
                res = {'ok': False, 'error': f'internal error: {e}'}
        res['req_id'] = req.get('req_id')
        self.resp_pub.publish(String(data=json.dumps(res)))
        self._publish_places()
        return res

    # ---------------------------------------------------------------- loop
    def _lookup(self, parent, child):
        tf = self.tf_buffer.lookup_transform(parent, child, Time())
        age = (self.get_clock().now() - Time.from_msg(tf.header.stamp)).nanoseconds / 1e9
        t = tf.transform
        return (t.translation.x, t.translation.y,
                yaw_from_quaternion(t.rotation.x, t.rotation.y, t.rotation.z, t.rotation.w)), age

    def _pose(self):
        """Robot pose in the global frame.

        map->base_link = (map->odom from SLAM) ∘ (odom->base_link from the wheels, 50 Hz).
        SLAM's correction can arrive a second or more late on a busy Pi; it changes slowly, so it
        may be old. Only the wheel part has to be fresh. (Looking up map->base_link directly would
        take the OLDER of the two and report the robot as lost.)
        """
        try:
            if self.global_frame == self.odom_frame:
                pose, age = self._lookup(self.global_frame, self.base_frame)
                return pose if age <= self.pose_timeout else None
            odom_pose, odom_age = self._lookup(self.odom_frame, self.base_frame)
            if odom_age > self.pose_timeout:
                return None
            correction, map_age = self._lookup(self.global_frame, self.odom_frame)
            if map_age > self.map_tf_timeout:
                self.get_logger().warn(f'SLAM correction (map->odom) is {map_age:.1f} s old: is Cartographer '
                                       'running and keeping up?', throttle_duration_sec=10.0)
                return None
            last, self._last_corr = self._last_corr, correction
            if last is not None:
                # where the robot stands now, with the old and the new correction: the difference is how far
                # SLAM just moved the robot on the map in one step (wrong re-match, loop closure, bad odometry)
                a, b = compose_2d(last, odom_pose), compose_2d(correction, odom_pose)
                d = math.hypot(b[0] - a[0], b[1] - a[1])
                dyaw = abs(math.atan2(math.sin(b[2] - a[2]), math.cos(b[2] - a[2])))
                if d > 0.30 or dyaw > math.radians(12):
                    self._corr_jumps.append((d, dyaw))
            return compose_2d(correction, odom_pose)
        except TransformException:
            return None

    # ---------------------------------------------------------------- Nav2 backend (nav2_follower.py)
    def _setup_nav2(self):
        """Nav2 plans and drives; the core keeps missions and safety. Falls back to the built-in follower
        when Nav2 is not installed, so a missing package never leaves the robot unable to move."""
        try:
            from rclpy.action import ActionClient
            from nav2_msgs.action import FollowPath, NavigateToPose
        except ImportError as e:
            self.get_logger().error(f'nav_backend nav2 asked for, but Nav2 is not installed ({e}). Using the '
                                    f'built-in planner. Install: sudo apt install ros-humble-navigation2')
            self.nav_backend = 'pathik'
            return
        from lidar_robot.nav2_follower import Nav2Follower
        self._nav2 = {'navigate': (ActionClient(self, NavigateToPose, 'navigate_to_pose'), NavigateToPose),
                      'follow': (ActionClient(self, FollowPath, 'follow_path'), FollowPath)}
        self._nav2_handles = {}
        fol = Nav2Follower(self.core.follower.p, self._nav2_send, self._nav2_cancel,
                           clock=lambda: self.get_clock().now().nanoseconds * 1e-9, mode=str(self.get_parameter('nav2_mode').value))
        with self.core_lock:
            self.core.follower = fol
            self.core.nav_backend = 'nav2'
        self._nav2_fol = fol
        self.create_subscription(Twist, str(self.get_parameter('nav2_cmd_topic').value),
                                 lambda m: fol.on_cmd(m.linear.x, m.angular.z), 10)
        self.create_subscription(Path, 'plan', lambda m: fol.on_plan(
            [(ps.pose.position.x, ps.pose.position.y) for ps in m.poses][::max(1, len(m.poses) // 200)]
            + ([(m.poses[-1].pose.position.x, m.poses[-1].pose.position.y)] if m.poses else [])), 1)
        self.get_logger().info(f'navigation backend: Nav2 ({fol.mode}); Pathik keeps missions and the safety checks')

    def _nav2_pose(self, x, y, yaw):
        ps = PoseStamped()
        ps.header.frame_id = self.global_frame
        ps.header.stamp = self.get_clock().now().to_msg()
        ps.pose.position.x, ps.pose.position.y = float(x), float(y)
        ps.pose.orientation.z, ps.pose.orientation.w = math.sin(yaw / 2.0), math.cos(yaw / 2.0)
        return ps

    def _nav2_send(self, seq, mode, pts, goal):
        client, kind = self._nav2[mode]
        fol = self._nav2_fol
        if not client.server_is_ready():
            # not up yet (Nav2 takes ~20 s to start on the Pi): the follower waits start_timeout, then reports it
            self.get_logger().warn(f'Nav2 action server for "{mode}" is not ready yet', throttle_duration_sec=5.0)
            if not client.wait_for_server(timeout_sec=0.0):
                fol.on_accepted(seq, False, 'Nav2 is not running yet')
                return
        g = kind.Goal()
        if mode == 'navigate':
            g.pose = self._nav2_pose(*goal)
        else:
            g.path = Path()
            g.path.header.frame_id = self.global_frame
            g.path.header.stamp = self.get_clock().now().to_msg()
            for (x, y), (nx, ny) in zip(pts, pts[1:] + [pts[-1]]):
                yaw = goal[2] if (x, y) == (nx, ny) else math.atan2(ny - y, nx - x)
                g.path.poses.append(self._nav2_pose(x, y, yaw))

        def accepted(fut):
            try:
                handle = fut.result()
            except Exception as e:
                fol.on_accepted(seq, False, f'Nav2 goal failed: {e}')
                return
            if not handle.accepted:
                fol.on_accepted(seq, False, 'Nav2 refused the goal')
                return
            fol.on_accepted(seq, True)
            self._nav2_handles[seq] = handle
            if seq != fol.seq:                       # replaced while we waited: cancel it at once
                handle.cancel_goal_async()
                return

            def done(rf):
                self._nav2_handles.pop(seq, None)
                try:
                    status = rf.result().status
                except Exception as e:
                    fol.on_result(seq, False, f'Nav2 result failed: {e}')
                    return
                # action_msgs/GoalStatus: 4 succeeded, 5 canceled, 6 aborted
                fol.on_result(seq, status == 4, {5: 'Nav2 goal was cancelled', 6: 'Nav2 gave up: no route or stuck'}
                              .get(status, f'Nav2 ended with status {status}'))
            handle.get_result_async().add_done_callback(done)
        client.send_goal_async(g).add_done_callback(accepted)

    def _nav2_cancel(self, seq):
        handle = self._nav2_handles.pop(seq, None)
        if handle is not None:
            handle.cancel_goal_async()

    def _tick(self):
        pose = self._pose()
        front = self.front
        if self.scan_stamp is None or (self.get_clock().now() - self.scan_stamp).nanoseconds > 1e9:
            front = 0.0                                  # no fresh scan: never drive forward
            with self.core_lock:
                self.core.update_scan_base([])           # ...and don't trust old body checks
        front = min(front, self.us.front_clearance(self.half_width))
        try:
            with self.core_lock:
                jumps, self._corr_jumps = self._corr_jumps, []
                for d, dyaw in jumps:
                    self.core.note_map_jump(d, dyaw)
                v, w = self.core.step(pose, front, self.dt)
                active = bool(self.core.queue.active)
            v, w = self.vision.apply(v, w, time.monotonic())   # camera: people in the path
            if self.vision.note and self.vision.note != self._vision_said:
                self.get_logger().info(self.vision.note)
                if 'waiting' in self.vision.note:
                    self.speaker.say(str(self.get_parameter('pass_text').value), key='make_way', gap_s=12.0)
            self._vision_said = self.vision.note
            with self.core_lock:
                says, self.core.say_queue = self.core.say_queue, []
            for key, text in says:
                self.speaker.say(text, key=key, gap_s=12.0 if key in ('make_way', 'thanks') else 3.0)
        except Exception as e:                           # stop, report, keep the node alive
            self.get_logger().error(f'navigator step failed: {e}\n{traceback.format_exc()}')
            self.cmd_pub.publish(Twist())
            with self.core_lock:
                self.core._fail('INTERNAL', f'internal error: {e}')
            return
        if active or v or w or self._was_active:       # keep streaming while busy, one stop after
            cmd = Twist()
            cmd.linear.x, cmd.angular.z = float(v), float(w)
            self.cmd_pub.publish(cmd)
        self._was_active = active

    def _on_vision(self, msg: String):
        try:
            self.vision.update(json.loads(msg.data), time.monotonic())
            with self.core_lock:                         # person or object in the way? (blockers.py)
                self.core.see_people(self.vision.last if self.vision.enabled else None)
        except ValueError:
            pass

    def _on_marker(self, msg: String):
        try:
            obs = json.loads(msg.data)
        except ValueError:
            return
        with self.core_lock:
            self.core.set_marker(obs)

    def _publish_status(self):
        with self.core_lock:
            st = self.core.status()
            dock_mode = self.core.dock_mode()
            wants_marker = self.core.wants_marker()
        if dock_mode or getattr(self, '_dock_mode_was', False):
            self.dock_mode_pub.publish(Bool(data=dock_mode))
        if wants_marker:                          # keeps the camera's marker search on (it stops 3 s after)
            self.marker_req_pub.publish(Empty())
        self._dock_mode_was = dock_mode
        st['vision'] = self.vision.note       # e.g. "camera: person 0.7 m ahead: too close, waiting"
        self.status_pub.publish(String(data=json.dumps(st)))
        key = tuple(map(tuple, st['path'][:3])) + (len(st['path']),)
        if key != self.last_plan_sent:
            path = Path()
            path.header.frame_id = self.global_frame
            path.header.stamp = self.get_clock().now().to_msg()
            for x, y in st['path']:
                ps = PoseStamped()
                ps.header = path.header
                ps.pose.position.x, ps.pose.position.y = float(x), float(y)
                ps.pose.orientation.w = 1.0
                path.poses.append(ps)
            self.plan_pub.publish(path)
            self.last_plan_sent = key
        self._publish_places()

    def _publish_places(self):
        if self.places.version != self.places_version_sent:
            self.places_pub.publish(String(data=json.dumps(self.places.summary())))
            self.places_version_sent = self.places.version


def main(args=None):
    rclpy.init(args=args)
    node = NavigatorNode()
    try:
        rclpy.spin(node)
    except KeyboardInterrupt:
        pass
    finally:
        try:
            if rclpy.ok():
                node.cmd_pub.publish(Twist())
            node.destroy_node()
        except Exception:
            pass
        if rclpy.ok():
            rclpy.shutdown()


if __name__ == '__main__':
    main()
