ArpitAwasthi2411/slam-robot/ros2_ws/src/lidar_robot/lidar_robot/dashboard.py

#!/usr/bin/env python3
"""Web teleop dashboard node. Open http://<pi-ip>:8080 from the laptop or a phone.

Publishes   /cmd_vel_teleop (Twist)  /estop (Bool, latched)  /goal_pose  /goal_cancel
            /navigator/request (String JSON)
Subscribes  /map  /scan  /robot/status  /goal_controller/status  /navigator/status
            /navigator/places  /navigator/response  /vision/decision  /vision/image/compressed
            + TF map->base_link
Map saving writes ~/maps/<name>.pgm/.yaml (map_server format) from /map, plus
~/maps/<name>.pbstream (Cartographer state, for slam_mode:=localization) when SLAM is running.
"""
import base64
import itertools
import json
import math
import os
import threading
import time

import numpy as np
import rclpy
from rclpy.node import Node
from rclpy.qos import QoSProfile, DurabilityPolicy, ReliabilityPolicy, qos_profile_sensor_data
from rclpy.time import Time
from geometry_msgs.msg import PoseStamped, Twist
from nav_msgs.msg import OccupancyGrid
from sensor_msgs.msg import CompressedImage, LaserScan
from std_msgs.msg import Bool, Empty, String
from tf2_ros import Buffer, TransformListener, TransformException

from lidar_robot.auth import UserStore
from lidar_robot.dashboard_server import DashboardServer
from lidar_robot.explorer import MapAutoSaver
from lidar_robot.kinematics import yaw_from_quaternion, quaternion_from_yaw, wrap_angle
from lidar_robot import map_mode
from lidar_robot.mapsave import save_map
from lidar_robot.pihealth import PiHealth
from lidar_robot.vision_rules import clean_phone_detections
from lidar_robot import scan_points
from lidar_robot.tuning import TelemetryBuffer, TestRunner, ranges_for_app, WHEEL_RANGES

APP_API = 2


class DashboardNode(Node):
    def __init__(self):
        super().__init__('dashboard')
        self.declare_parameter('port', 8080)
        self.declare_parameter('global_frame', 'map')
        self.declare_parameter('fallback_frame', 'odom')
        self.declare_parameter('base_frame', 'base_link')
        self.declare_parameter('max_linear', 0.30)
        self.declare_parameter('max_angular', 1.2)
        self.declare_parameter('map_dir', os.path.expanduser('~/maps'))
        self.declare_parameter('require_login', True)            # app users + roles (auth.py)
        self.declare_parameter('users_file', os.path.expanduser('~/maps/users.json'))
        # written by scripts/setup_tailscale.sh funnel on (public https URL), removed by funnel off
        self.declare_parameter('public_flag_file', os.path.expanduser('~/maps/.public_url'))
        self.declare_parameter('scan_decimation', 3)
        self.declare_parameter('nav_mode', 'planner')
        self.declare_parameter('slam_mode', 'mapping')           # bringup passes the real one
        self.declare_parameter('carto_config_dir', '')
        self.declare_parameter('map_file', '')                 # the saved map in use (bringup passes it)
        self.declare_parameter('map_mode_file', '')            # app's map-mode choice (map_mode.py)
        gp = lambda n: self.get_parameter(n).value  # noqa: E731
        self.global_frame = gp('global_frame')
        self.fallback_frame = gp('fallback_frame')
        self.base_frame = gp('base_frame')
        self.max_v = float(gp('max_linear'))
        self.max_w = float(gp('max_angular'))
        self.map_dir = gp('map_dir')
        self.scan_dec = max(1, int(gp('scan_decimation')))
        self.nav_mode = gp('nav_mode')

        self.lock = threading.Lock()
        self.map_msg = None
        self.map_version = 0
        self.map_cache = None          # (version, dict)
        self.scan_msg = None           # latest scan; turned into app points only when an app asks
        self.scan_pts, self.scan_pts_of = [], None
        self.scan_geo = scan_points.ScanGeometry()
        self.scan_times = []
        self.state_cache = (0.0, None)  # several phones polling share one state build (STATE_CACHE_S)
        self.pihealth = PiHealth()
        self.create_timer(15.0, self._warn_pi)
        self.laser_tf = None
        self.robot_status = {}
        self.robot_status_t = 0.0
        self.goal_status = {}
        self.estop = False                 # mirrors the bridge's value (bridge is authoritative)
        self.nav_status = {}
        self.nav_status_t = 0.0
        self.autosave = MapAutoSaver(self.save_map)      # exploration finished -> save the map
        self.places = {'places': [], 'home': None, 'version': -1}
        self.pending = {}                  # req_id -> [Event, response]
        self.req_ids = itertools.count(1)

        self.tf_buffer = Buffer()
        self.tf_listener = TransformListener(self.tf_buffer, self, spin_thread=True)

        latched = QoSProfile(depth=1, durability=DurabilityPolicy.TRANSIENT_LOCAL,
                             reliability=ReliabilityPolicy.RELIABLE)
        self.cmd_pub = self.create_publisher(Twist, 'cmd_vel_teleop', 10)
        self.estop_pub = self.create_publisher(Bool, 'estop', latched)
        self.goal_pub = self.create_publisher(PoseStamped, 'goal_pose', 10)
        self.cancel_pub = self.create_publisher(Empty, 'goal_cancel', 10)
        self.nav_req_pub = self.create_publisher(String, 'navigator/request', 10)
        self.esp_cmd_pub = self.create_publisher(String, 'robot/esp_cmd', 10)
        self.telemetry = TelemetryBuffer()
        self.create_subscription(String, 'robot/wheel_telemetry', self._on_wheel_telemetry, 20)
        self.tests = TestRunner(self._test_cmd, self._test_sample,
                                is_blocked=lambda: self.estop or self.robot_status.get('esp_mode') == 'RC')
        # NOTE: never publish /estop at startup: a restarted dashboard must not release an e-stop

        # volatile+reliable matches both cartographer (volatile) and map_server (latched)
        self.create_subscription(OccupancyGrid, 'map', self._on_map, 1)
        self.create_subscription(LaserScan, 'scan', self._on_scan, qos_profile_sensor_data)
        self.create_subscription(String, 'robot/status', self._on_robot_status, 10)
        self.create_subscription(String, 'goal_controller/status', self._on_goal_status, 10)
        self.create_subscription(String, 'navigator/status', self._on_nav_status, 10)
        self.create_subscription(String, 'navigator/places', self._on_places, latched)
        self.create_subscription(String, 'navigator/response', self._on_nav_response, 10)
        self.vision, self.vision_t, self.camera, self.camera_t = None, 0.0, None, 0.0
        self.create_subscription(String, 'vision/decision', self._on_vision, 10)
        self.create_subscription(CompressedImage, 'vision/image/compressed', self._on_camera, 2)
        self.stream_req_pub = self.create_publisher(Empty, 'vision/stream_request', 5)
        self._stream_req_t = 0.0
        # the phone in the robot's head: plain camera frames out, people boxes back in
        self.raw, self.raw_t, self._raw_req_t = None, 0.0, 0.0
        self.create_subscription(CompressedImage, 'vision/raw/compressed', self._on_raw, 2)
        self.raw_req_pub = self.create_publisher(Empty, 'vision/raw_request', 5)
        self.phone_pub = self.create_publisher(String, 'vision/phone_boxes', 10)
        self.voice, self.voice_t = None, 0.0
        self.create_subscription(String, 'voice/status', self._on_voice, 10)
        self.voice_pub = self.create_publisher(String, 'voice/control', 10)
        self.write_state_cli = None
        try:                                # Cartographer service to save a .pbstream (optional)
            from cartographer_ros_msgs.srv import WriteState
            self._WriteState = WriteState
            self.write_state_cli = self.create_client(WriteState, 'write_state')
        except ImportError:
            self._WriteState = None
        self.slam_mode = str(self.get_parameter('slam_mode').value)
        self.carto_config_dir = str(self.get_parameter('carto_config_dir').value)
        self.map_file = str(self.get_parameter('map_file').value)
        self.map_mode_file = str(self.get_parameter('map_mode_file').value)
        self.switching = None              # {'mode', 'map', 'say'} once a map-mode switch started
        self._carto = None
        try:                                # Cartographer trajectory services, for "Set position"
            from cartographer_ros_msgs.srv import FinishTrajectory, GetTrajectoryStates, StartTrajectory
            self._carto = {
                'types': (FinishTrajectory, GetTrajectoryStates, StartTrajectory),
                'finish': self.create_client(FinishTrajectory, 'finish_trajectory'),
                'states': self.create_client(GetTrajectoryStates, 'get_trajectory_states'),
                'start': self.create_client(StartTrajectory, 'start_trajectory'),
            }
        except ImportError:
            pass

        port = int(gp('port'))
        users = UserStore(gp('users_file')) if gp('require_login') else None
        self.server = DashboardServer(self, port=port, users=users,
                                      public_flag=os.path.expanduser(gp('public_flag_file')))
        self.server.start()
        if os.path.exists(os.path.expanduser(gp('public_flag_file'))):
            self.get_logger().warn('Tailscale Funnel is ON: the app is reachable from the internet. '
                                   'Turn it off with: sudo bash scripts/setup_tailscale.sh funnel off')
        self.get_logger().info(f'Dashboard on http://0.0.0.0:{port}  (open http://<pi-ip>:{port})')
        if users is None:
            self.get_logger().warn('require_login is false: ANYONE on the network can drive the robot')
        elif users.setup_needed():
            self.get_logger().warn('No admin account yet: the first person to sign up in the app becomes admin')

    # ------------------------------------------------------------ ROS callbacks
    def _on_map(self, msg):
        with self.lock:
            self.map_msg = msg
            self.map_version += 1

    def _on_scan(self, msg: LaserScan):
        if self.laser_tf is None:
            try:
                tf = self.tf_buffer.lookup_transform(self.base_frame, msg.header.frame_id, Time())
                t = tf.transform
                self.laser_tf = (t.translation.x, t.translation.y,
                                 yaw_from_quaternion(t.rotation.x, t.rotation.y, t.rotation.z, t.rotation.w))
            except TransformException:
                return
        now = time.monotonic()
        with self.lock:
            self.scan_msg = msg
            self.scan_times = [t for t in self.scan_times if now - t < 2.0] + [now]

    def _app_scan_points(self):
        """The latest scan as app points (base_link), computed at most once per scan and only on demand."""
        with self.lock:
            msg, done = self.scan_msg, self.scan_pts_of
        if msg is None or self.laser_tf is None:
            return []
        if msg is not done:
            pts = scan_points.app_points(self.scan_geo, msg.ranges, msg.angle_min, msg.angle_increment,
                                         msg.range_min, msg.range_max, laser=self.laser_tf,
                                         decimation=self.scan_dec)
            with self.lock:
                self.scan_pts, self.scan_pts_of = pts, msg
        return self.scan_pts

    def _warn_pi(self):
        h = self.pihealth.sample()
        if h.get('level') == 'bad':
            self.get_logger().warn(f"Raspberry Pi: {h['text']} (temp {h.get('temp_c')} C, "
                                   f"throttled {h.get('throttled')})", throttle_duration_sec=60.0)

    def _on_robot_status(self, msg):
        try:
            self.robot_status = json.loads(msg.data)
            self.robot_status_t = time.monotonic()
            self.estop = bool(self.robot_status.get('estop', False))
        except ValueError:
            pass

    def _on_wheel_telemetry(self, msg):
        try:
            batch = json.loads(msg.data).get('s', [])
        except ValueError:
            return
        now = time.monotonic()
        n = len(batch)
        for i, smp in enumerate(batch):       # 50 Hz samples arrive in 10 Hz batches: spread the stamps
            if isinstance(smp, list) and len(smp) == 6:
                self.telemetry.add(smp, now - (n - 1 - i) * 0.02)

    def _on_goal_status(self, msg):
        try:
            self.goal_status = json.loads(msg.data)
        except ValueError:
            pass

    def _on_nav_status(self, msg):
        try:
            self.nav_status = json.loads(msg.data)
            self.nav_status_t = time.monotonic()
        except ValueError:
            return
        self.autosave.update(self.nav_status.get('explore'))

    def _on_places(self, msg):
        try:
            self.places = json.loads(msg.data)
        except ValueError:
            pass

    def _on_nav_response(self, msg):
        try:
            res = json.loads(msg.data)
        except ValueError:
            return
        slot = self.pending.get(res.get('req_id'))
        if slot:
            slot[1] = res
            slot[0].set()

    def _us_mounts(self):
        """[x, y, yaw] of us_left/center/right in base_link from TF (cached once found)."""
        if getattr(self, '_mounts', None):
            return self._mounts
        out = []
        for f in ('us_left', 'us_center', 'us_right'):
            try:
                t = self.tf_buffer.lookup_transform(self.base_frame, f, Time()).transform
            except TransformException:
                return None
            out.append([t.translation.x, t.translation.y,
                        yaw_from_quaternion(t.rotation.x, t.rotation.y, t.rotation.z, t.rotation.w)])
        self._mounts = out
        return out

    def _pose(self):
        for frame in (self.global_frame, self.fallback_frame):
            try:
                tf = self.tf_buffer.lookup_transform(frame, self.base_frame, Time())
                t = tf.transform
                yaw = yaw_from_quaternion(t.rotation.x, t.rotation.y, t.rotation.z, t.rotation.w)
                return {'frame': frame, 'x': round(t.translation.x, 3),
                        'y': round(t.translation.y, 3), 'yaw': round(yaw, 4)}
            except TransformException:
                continue
        return None

    def _on_vision(self, msg):
        try:
            v = json.loads(msg.data)
        except ValueError:
            return
        for p in v.get('people', []):
            p.pop('conf', None)
        self.vision, self.vision_t = v, time.monotonic()

    def _on_camera(self, msg):
        self.camera, self.camera_t = bytes(msg.data), time.monotonic()

    def _on_raw(self, msg):
        self.raw, self.raw_t = bytes(msg.data), time.monotonic()

    def phone_detections(self, body):
        """POST /api/vision/phone: people boxes the phone found on a plain camera frame.
        {"boxes": [[x1, y1, x2, y2, conf], ...], "w": 640, "h": 360, "ms": 85}. The vision node uses them
        instead of its own YOLO while they keep coming (and falls back to its own after 1 s without)."""
        msg = clean_phone_detections(body)
        self.phone_pub.publish(String(data=json.dumps(msg)))
        return {'ok': True, 'n': len(msg['boxes'])}

    def _on_voice(self, msg):
        try:
            self.voice, self.voice_t = json.loads(msg.data), time.monotonic()
        except ValueError:
            pass

    def voice_control(self, body):
        action = str((body or {}).get('action', 'listen'))
        if action not in ('listen', 'stop'):
            return {'ok': False, 'error': 'action must be listen or stop'}
        if not self.voice or time.monotonic() - self.voice_t > 5.0:
            return {'ok': False, 'error': 'the voice node is not running on the robot (voice:=true, scripts/setup_voice.sh)'}
        self.voice_pub.publish(String(data=json.dumps({'action': action, 'by': (body or {}).get('by', ''),
                                                       'max_s': float((body or {}).get('max_s', 8.0))})))
        return {'ok': True}

    def camera_jpeg(self, raw=False):
        now = time.monotonic()
        if raw:                                       # plain picture for the phone detector
            if now - self._raw_req_t > 1.0:
                self._raw_req_t = now
                self.raw_req_pub.publish(Empty())
            return self.raw if now - self.raw_t < 2.0 else None
        if now - self._stream_req_t > 1.0:           # someone is watching: ask the vision node to stream
            self._stream_req_t = now
            self.stream_req_pub.publish(Empty())
        return self.camera if time.monotonic() - self.camera_t < 2.0 else None

    # ------------------------------------------------------------ backend API
    STATE_CACHE_S = 0.1

    def get_state(self):
        """Everything the app shows. Built at most every STATE_CACHE_S, however many phones poll."""
        t, st = self.state_cache
        if st is not None and time.monotonic() - t < self.STATE_CACHE_S:
            return st
        st = self._build_state()
        self.state_cache = (time.monotonic(), st)
        return st

    def _build_state(self):
        # status comes at 2 Hz; 3 s so a busy Pi (Cartographer) doesn't flash 'not talking'
        alive = time.monotonic() - self.robot_status_t < 3.0
        rs = self.robot_status if alive else {}
        pts = self._app_scan_points()
        with self.lock:
            m = self.map_msg
            scan_hz = len(self.scan_times) / 2.0
        odom = rs.get('odom', {})
        return {
            'time': time.time(),
            'link': {k: rs.get(k) for k in ('connected', 'port', 'rx_hz', 'rx_age', 'esp_mode',
                                            'esp_info', 'cmd_source', 'bad_lines', 'drops')},
            'bridge_alive': alive,
            'estop': self.estop,
            'pose': self._pose(),
            'odom': {'v': odom.get('v'), 'w': odom.get('w')},
            'cmd': {'v': rs.get('cmd_v'), 'w': rs.get('cmd_w')},
            'scan': {'hz': scan_hz, 'points': pts},
            'goal': self.goal_status,
            'map': None if m is None else {'version': self.map_version, 'width': m.info.width,
                                           'height': m.info.height, 'resolution': m.info.resolution},
            'limits': {'max_v': self.max_v, 'max_w': self.max_w},
            'nav_mode': self.nav_mode,
            'sensors': {'us': rs.get('us'), 'imu_ok': rs.get('imu_ok'), 'yaw_source': rs.get('yaw_source'),
                        'bumper': rs.get('bumper'), 'battery_raw': rs.get('battery'),
                        'us_mounts': self._us_mounts()},
            'nav': self.nav_status if time.monotonic() - self.nav_status_t < 2.0 else None,
            'tune': rs.get('tune'), 'fw': rs.get('fw'), 'telemetry': rs.get('telemetry'),
            'turns': odom.get('turns'), 'sep': rs.get('sep'), 'gyro_scale': rs.get('gyro_scale'), 'test_running': bool(self.tests.result.get('running')),
            'autosave': self.autosave.info,
            'slam_mode': self.slam_mode,
            'map_name': os.path.basename(self.map_file)[:-9] if self.map_file.endswith('.pbstream') else '',
            'switching': self.switching,
            'places': self.places,
            'vision': self.vision if time.monotonic() - self.vision_t < 2.0 else None,
            'camera': time.monotonic() - self.camera_t < 2.0,
            'voice': self.voice if time.monotonic() - self.voice_t < 5.0 else None,
            'pi': self.pihealth.sample(),
        }

    # ------------------------------------------------------------ mobile app / Tuning Lab
    def ping(self):
        rs = self.robot_status
        return {'ok': True, 'robot': 'slam-robot', 'api': APP_API, 'fw': rs.get('fw'),
                'host': os.uname().nodename, 'nav_mode': self.nav_mode,
                'wheel_ranges': ranges_for_app(WHEEL_RANGES)}

    def esp_command(self, req):
        op = req.get('op')
        if op not in ('tune', 'save', 'defaults', 'telemetry', 'query', 'i2c_scan'):
            raise ValueError('unknown op')
        self.esp_cmd_pub.publish(String(data=json.dumps(req)))
        return {'ok': True}

    def get_telemetry(self, since):
        return self.telemetry.since(since)

    def _test_cmd(self, v, w):
        t = Twist()
        t.linear.x, t.angular.z = v, w
        self.cmd_pub.publish(t)

    def _test_sample(self):
        p = self._pose()
        odom = self.robot_status.get('odom', {})
        if not p:
            return None
        return {'x': p['x'], 'y': p['y'], 'yaw': p['yaw'], 'v': odom.get('v'), 'w': odom.get('w'),
                'turns': odom.get('turns')}

    def test_start(self, req):
        if self.estop:
            raise ValueError('release the e-stop first')
        return self.tests.start(req)

    def test_stop(self):
        return self.tests.stop()

    def test_status(self, since):
        return self.tests.status(since)

    def get_map(self, since):
        with self.lock:
            m, ver = self.map_msg, self.map_version
            if m is None or since == ver:
                return None
            if self.map_cache and self.map_cache[0] == ver:
                return self.map_cache[1]
        # unknown(-1)->0, 0..100 -> 1..101 so it fits in a byte (numpy: ~100x faster than a Python loop)
        d = np.asarray(m.data, dtype=np.int16)
        raw = np.where(d >= 0, d + 1, 0).astype(np.uint8).tobytes()
        o = m.info.origin
        out = {
            'version': ver, 'width': m.info.width, 'height': m.info.height,
            'resolution': m.info.resolution,
            'origin': [o.position.x, o.position.y,
                       yaw_from_quaternion(o.orientation.x, o.orientation.y, o.orientation.z, o.orientation.w)],
            'data': base64.b64encode(raw).decode(),
        }
        with self.lock:
            self.map_cache = (ver, out)
        return out

    def command(self, v, w):
        if self.estop or not (math.isfinite(v) and math.isfinite(w)):
            return
        t = Twist()
        t.linear.x = max(-self.max_v, min(self.max_v, v))
        t.angular.z = max(-self.max_w, min(self.max_w, w))
        self.cmd_pub.publish(t)

    def set_estop(self, on):
        self.estop = bool(on)                  # immediate local block; bridge status confirms
        self.estop_pub.publish(Bool(data=self.estop))
        if self.estop:
            self.cmd_pub.publish(Twist())
            if self.nav_mode != 'planner':        # the navigator pauses its missions itself
                self.cancel_pub.publish(Empty())

    def send_goal(self, x, y, yaw):
        pose = self._pose()
        frame = pose['frame'] if pose else self.global_frame
        msg = PoseStamped()
        msg.header.frame_id = frame
        msg.header.stamp = self.get_clock().now().to_msg()
        msg.pose.position.x, msg.pose.position.y = x, y
        _, _, qz, qw = quaternion_from_yaw(wrap_angle(yaw))
        msg.pose.orientation.z, msg.pose.orientation.w = qz, qw
        self.goal_pub.publish(msg)

    def cancel_goal(self):
        self.cancel_pub.publish(Empty())
        self.cmd_pub.publish(Twist())

    def nav_request(self, req):
        """Forward a JSON request to the navigator node and wait (max 3 s) for its reply."""
        if self.nav_mode != 'planner':
            return {'ok': False, 'error': 'navigator not running (bringup nav_mode:=planner)'}
        rid = next(self.req_ids)
        req = dict(req, req_id=rid)
        ev = threading.Event()
        self.pending[rid] = [ev, None]
        self.nav_req_pub.publish(String(data=json.dumps(req)))
        # commands may go through the LLM (up to ~2 x llm_timeout with a model fallback); the AI test more
        ok = ev.wait({'command': 20.0, 'llm_test': 30.0}.get(req.get('type'), 3.0))
        res = self.pending.pop(rid)[1]
        if not ok or res is None:
            return {'ok': False, 'error': 'navigator did not answer (is it running?)'}
        return res

    def save_map(self, name):
        with self.lock:
            m = self.map_msg
        if m is None:
            raise ValueError('no /map received yet')
        o = m.info.origin
        yaw = yaw_from_quaternion(o.orientation.x, o.orientation.y, o.orientation.z, o.orientation.w)
        _, yaml_path = save_map(self.map_dir, name, m.info.width, m.info.height, m.info.resolution,
                                o.position.x, o.position.y, yaw, m.data)
        self.get_logger().info(f'Map saved: {yaml_path}')
        saved = yaml_path
        pb = self._write_pbstream(yaml_path[:-5] + '.pbstream')
        if pb:
            saved += f' + {os.path.basename(pb)}'
        else:
            saved += ' (WARNING: no .pbstream saved: Cartographer write_state unavailable, '
            saved += 'localization mode will not work with this map)'
        return saved

    def _call(self, cli, req, timeout=5.0):
        if not cli.service_is_ready():
            raise ValueError(f'Cartographer service {cli.srv_name} is not available (is SLAM running?)')
        with self.lock:
            fut = cli.call_async(req)
        t0 = time.monotonic()
        while not fut.done() and time.monotonic() - t0 < timeout:
            time.sleep(0.05)
        if not fut.done() or fut.result() is None:
            raise ValueError(f'Cartographer did not answer {cli.srv_name}')
        return fut.result()

    def relocalize(self, body):
        """'Set position' (like RViz 2D Pose Estimate): restart Cartographer's localization at a pose.

        Finishes the active localization trajectory and starts a new one with an initial pose relative
        to the frozen map trajectory, so scan matching starts from where the operator says the robot is.
        """
        x, y, yaw = float(body['x']), float(body['y']), float(body.get('yaw', 0.0))
        if not all(math.isfinite(v) for v in (x, y, yaw)):
            raise ValueError('pose must be finite numbers')
        if self.slam_mode != 'localization':
            raise ValueError('Set position is for a saved map (localization mode). While mapping, the map '
                             'is built around the robot, so its position is always right by definition.')
        if not self._carto:
            raise ValueError('cartographer_ros_msgs not installed')
        FinishTrajectory, GetTrajectoryStates, StartTrajectory = self._carto['types']
        st = self._call(self._carto['states'], GetTrajectoryStates.Request()).trajectory_states
        ids, states = list(st.trajectory_id), list(st.trajectory_state)
        frozen = [i for i, s_ in zip(ids, states) if s_ == 2]          # FROZEN = the saved map
        active = [i for i, s_ in zip(ids, states) if s_ == 0]          # ACTIVE = current localization
        for i in active:
            self._call(self._carto['finish'], FinishTrajectory.Request(trajectory_id=int(i)))
        req = StartTrajectory.Request()
        req.configuration_directory = self.carto_config_dir
        req.configuration_basename = 'cartographer_localization.lua'
        req.use_initial_pose = True
        req.initial_pose.position.x, req.initial_pose.position.y = x, y
        qx, qy, qz, qw = quaternion_from_yaw(yaw)
        req.initial_pose.orientation.x, req.initial_pose.orientation.y = qx, qy
        req.initial_pose.orientation.z, req.initial_pose.orientation.w = qz, qw
        req.relative_to_trajectory_id = int(frozen[0]) if frozen else 0
        res = self._call(self._carto['start'], req)
        if res.status.code != 0:
            raise ValueError(f'Cartographer refused the new pose: {res.status.message}')
        self.get_logger().info(f'Set position: x={x:.2f} y={y:.2f} yaw={math.degrees(yaw):.0f}° '
                               f'(new trajectory {res.trajectory_id})')
        return {'ok': True, 'trajectory': int(res.trajectory_id)}

    # ---------------------------------------------------------------- map mode (app: Map tab)
    def slam_info(self):
        return {'mode': self.slam_mode, 'map': self.map_file,
                'map_name': os.path.basename(self.map_file)[:-9] if self.map_file.endswith('.pbstream') else '',
                'maps': [{k: m[k] for k in ('name', 'size_kb', 'mtime', 'picture')}
                         for m in map_mode.list_maps(self.map_dir)],
                'can_switch': bool(self.map_mode_file) and self.slam_mode in map_mode.MODES,
                'auto_restart': bool(os.environ.get('INVOCATION_ID')),     # started by systemd (robot.service)
                'switching': self.switching}

    def _busy(self):
        n = self.nav_status if time.monotonic() - self.nav_status_t < 2.0 else {}
        if (n.get('explore') or {}).get('active'):
            return 'it is exploring (stop "Map by itself" first)'
        if (n.get('missions') or {}).get('active') or n.get('state') not in (None, 'IDLE'):
            return f'it is busy ({str(n.get("state", "")).lower()}): cancel the task first'
        return None

    def slam_switch(self, body):
        """Freeze the map / continue mapping / new map / drive on a saved map, then restart."""
        if not self.map_mode_file or self.slam_mode not in map_mode.MODES:
            raise ValueError('Map mode switching needs SLAM running from bringup (map_mode_file set).')
        if self.switching:
            raise ValueError('Already switching: the robot is restarting.')
        why = self._busy()
        if why:
            raise ValueError(f'Not now: {why}.')
        plan = map_mode.plan_switch(str(body.get('action', '')), self.slam_mode, self.map_file, self.map_dir,
                                    name=body.get('name'), map_name=body.get('map'))
        if plan['save_as']:
            self._finish_active_trajectories()           # final optimisation: the saved map is the best one
            saved = self.save_map(plan['save_as'])
            if 'WARNING' in saved or not os.path.isfile(plan['map']):
                raise ValueError('Could not save the .pbstream (Cartographer not answering), the map was not '
                                 'frozen. Try again in a few seconds.')
        map_mode.write_mode(self.map_mode_file, plan['mode'], plan['map'])
        auto = bool(os.environ.get('INVOCATION_ID'))
        say = plan['say'] + ('' if auto else ' (Started by hand, not by robot.service: start it again yourself.)')
        self.switching = {'mode': plan['mode'], 'map': os.path.basename(plan['map']), 'say': say}
        self.get_logger().warn(f'map mode -> {plan["mode"]} {plan["map"] or "(new map)"}: restarting')
        threading.Thread(target=self._exit_for_restart, daemon=True).start()
        return {'ok': True, 'say': say, 'mode': plan['mode'], 'map': os.path.basename(plan['map'])}

    def _finish_active_trajectories(self):
        if not self._carto:
            return
        try:
            FinishTrajectory, GetTrajectoryStates, _ = self._carto['types']
            st = self._call(self._carto['states'], GetTrajectoryStates.Request()).trajectory_states
            for i, s_ in zip(list(st.trajectory_id), list(st.trajectory_state)):
                if s_ == 0:                                  # ACTIVE
                    self._call(self._carto['finish'], FinishTrajectory.Request(trajectory_id=int(i)), timeout=60.0)
        except ValueError as e:                            # still save: write_state works without it
            self.get_logger().warn(f'finish_trajectory before freezing: {e}')

    def _exit_for_restart(self):
        time.sleep(2.0)                     # let the app get its answer and show the message
        os._exit(map_mode.RESTART_CODE)     # launch sees this code, shuts down, systemd restarts it

    def _write_pbstream(self, path):
        """Ask Cartographer to save its full state (needed for slam_mode:=localization)."""
        if not self.write_state_cli or not self.write_state_cli.service_is_ready():
            return None
        req = self._WriteState.Request()
        req.filename = path
        req.include_unfinished_submaps = True
        with self.lock:
            fut = self.write_state_cli.call_async(req)
        t0 = time.monotonic()
        while not fut.done() and time.monotonic() - t0 < 10.0:
            time.sleep(0.05)
        if fut.done() and fut.result() is not None and fut.result().status.code == 0:
            self.get_logger().info(f'Cartographer state saved: {path}')
            return path
        self.get_logger().warn('Could not save .pbstream (Cartographer busy or not running)')
        return None


def main(args=None):
    rclpy.init(args=args)
    node = DashboardNode()
    from rclpy.executors import MultiThreadedExecutor
    ex = MultiThreadedExecutor(num_threads=3)
    ex.add_node(node)
    try:
        ex.spin()
    except KeyboardInterrupt:
        pass
    finally:
        node.server.stop()
        node.destroy_node()
        if rclpy.ok():
            rclpy.shutdown()


if __name__ == '__main__':
    main()
