ArpitAwasthi2411/slam-robot/ros2_ws/src/lidar_robot/lidar_robot/esp32_bridge.py

#!/usr/bin/env python3
"""ESP32 bridge: encoder odometry in, velocity commands out.

Subscribes
  /cmd_vel          geometry_msgs/Twist   autonomous source (goal controller, Nav2)
  /cmd_vel_teleop   geometry_msgs/Twist   dashboard / keyboard — has priority
  /estop            std_msgs/Bool         emergency stop. Latched INSIDE the ESP32 too (blocks RC)
                                          until released with data:false. Works from the CLI:
                                          ros2 topic pub --once /estop std_msgs/msg/Bool "{data: true}"
Publishes
  /odom             nav_msgs/Odometry
  TF odom->base_link                      only if publish_tf (i.e. Cartographer uses odometry)
  /robot/status     std_msgs/String       JSON, 2 Hz (used by the dashboard)
  /imu              sensor_msgs/Imu       firmware v2.2 + MPU-6050 (frame imu_link)
  /ultrasonic/{left,center,right}  sensor_msgs/Range   firmware v2.2 + HC-SR04 (frames us_*)
  /robot/wheel_telemetry  std_msgs/String  JSON batches of 50 Hz SPD samples (firmware v2.3, Tuning Lab)
Subscribes (Tuning Lab)
  /robot/esp_cmd    std_msgs/String       JSON {"op": "tune"|"save"|"defaults"|"telemetry"|"query", ...}
With an IMU, odometry heading comes from the gyro (use_imu_yaw) and distance from the wheels.
"""
import json
import math
import os
import threading
import time

import rclpy
from rclpy.node import Node
from rclpy.qos import QoSProfile, DurabilityPolicy, ReliabilityPolicy
from geometry_msgs.msg import Twist, TransformStamped
from nav_msgs.msg import Odometry
from sensor_msgs.msg import Imu, Range
from std_msgs.msg import Bool, String
from tf2_ros import TransformBroadcaster

import serial

from lidar_robot.ports import pick_esp32_port
from lidar_robot.kinematics import (DiffDriveOdometry, quaternion_from_yaw,
                                    twist_to_wheels, limit_wheels)
from lidar_robot.protocol import (parse_line, OdomPacket, InfoPacket, ImuPacket, UsPacket, SpdPacket,
                                  BatPacket, BumpPacket,
                                  MODE_NAMES, MODE_ESTOP, parse_tune, format_tune, format_telemetry,
                                  format_velocity, format_stop, format_estop, format_dock,
                                  format_i2c_scan)
from lidar_robot.tuning import clamp_values, WHEEL_RANGES
from lidar_robot.odom_guard import OdomGuard


RESET_HINTS = {
    'BROWNOUT': 'Supply dipped: motors pulling the ESP32 power down -> 1000 uF cap on its 5 V, separate supply.',
    'POWERON': 'Power was lost completely: the ESP32 5V wire from the buck (or its USB cable), or the buck itself.',
    'EXT': 'RESET/EN pin pulsed: USB-serial DTR/RTS glitch or noise on EN.',
    'PANIC': 'Firmware crashed: send the log to Claude.',
    'INT_WDT': 'Firmware hung in an interrupt: likely noise on encoder/RC/echo pins flooding interrupts.',
    'TASK_WDT': 'Firmware hung: send the log to Claude.',
}


class Esp32Bridge(Node):
    def __init__(self):
        super().__init__('esp32_bridge')
        p = self.declare_parameter
        p('serial_port', 'auto')
        p('exclude_ports', '/dev/ttyUSB0')   # comma list; the launch passes the LiDAR port
        p('baud_rate', 115200)
        p('wheel_radius', 0.0625)
        p('wheel_separation', 0.30)
        p('ticks_per_rev_left', 4740.0)
        p('ticks_per_rev_right', 4740.0)
        p('publish_tf', True)
        p('odom_frame', 'odom')
        p('base_frame', 'base_link')
        p('cmd_timeout', 0.5)
        p('max_wheel_speed', 0.45)      # m/s, hard clamp on what we ask the ESP32
        p('cmd_rate', 20.0)
        p('use_imu_yaw', True)           # heading from the gyro when the firmware sends it
        p('gyro_scale', 1.0)             # gyro turn correction from the app's Spin test (MPU-6050 is +-3 %)
        g = lambda n: self.get_parameter(n).value  # noqa: E731

        self.port_param = g('serial_port')
        self.exclude_ports = [x for x in str(g('exclude_ports')).split(',') if x.strip()]
        self.warned_fallback = False
        self.baud = int(g('baud_rate'))
        self.publish_tf = bool(g('publish_tf'))
        self.odom_frame = g('odom_frame')
        self.base_frame = g('base_frame')
        self.cmd_timeout = float(g('cmd_timeout'))
        self.max_wheel = float(g('max_wheel_speed'))
        self.sep = float(g('wheel_separation'))
        self.odom = DiffDriveOdometry(float(g('wheel_radius')), self.sep,
                                      float(g('ticks_per_rev_left')),
                                      float(g('ticks_per_rev_right')))

        # cleans the packets before they become /odom: garbled lines, lost lines, gyro drift (odom_guard.py)
        self.guard = OdomGuard(self.odom.wheel_radius, self.odom.ticks_per_rev_left,
                               self.odom.ticks_per_rev_right, self.sep,
                               gyro_scale=float(g('gyro_scale')))

        self.lock = threading.Lock()
        self.ser = None
        self.port = None
        self.running = True
        self.rx_count = 0
        self.rx_hz = 0.0
        self.bad_lines = 0
        self.last_rx = 0.0
        self.esp_mode = -1
        self.esp_info = ''
        self.use_imu_yaw = bool(self.get_parameter('use_imu_yaw').value)
        self.gyro_scale = float(self.get_parameter('gyro_scale').value)
        self.last_imu = 0.0
        self.last_us = 0.0
        self.us = [None, None, None]
        self.bad_ports = {}                 # auto mode: ports that never sent ODM -> skipped for 60 s
        self.opened_at = 0.0
        self.odm_since_open = False
        self.battery = None                 # {"v", "a", "src"} from BAT lines (v2.4 firmware)
        self.last_bat = 0.0
        self.bumper = False
        self.bumps = 0
        self.yaw_source = 'wheels'
        self.cmd = {'teleop': (Twist(), 0.0), 'nav': (Twist(), 0.0)}
        self.cmd_source = 'none'
        self.cmd_out = (0.0, 0.0)
        self.zero_frames_left = 0
        self.estop = False
        self.estop_released_at = 0.0
        self.tune = None                  # last INFO,TUNE from the firmware (v2.3+)
        self.fw = ''
        self.telemetry_on = False         # what the app asked for (re-sent after an ESP32 reset)
        self.spd_batch = []
        # link diagnostics (shown in the app's Status and in the log): what kind of drop happened
        self.drops = {'usb': 0, 'resets': 0, 'gaps': 0}
        self.last_event = None              # (monotonic time, text)
        self.last_reset_reason = None

        self.odom_pub = self.create_publisher(Odometry, 'odom', 20)
        self.imu_pub = self.create_publisher(Imu, 'imu', 20)
        self.range_pubs = [self.create_publisher(Range, f'ultrasonic/{n}', 10)
                           for n in ('left', 'center', 'right')]
        self.status_pub = self.create_publisher(String, 'robot/status', 5)
        self.telem_pub = self.create_publisher(String, 'robot/wheel_telemetry', 10)
        self.create_subscription(String, 'robot/esp_cmd', self._on_esp_cmd, 10)
        self.create_timer(0.1, self._flush_telemetry)
        self.tf_pub = TransformBroadcaster(self) if self.publish_tf else None

        self.create_subscription(Twist, 'cmd_vel', lambda m: self._on_cmd('nav', m), 10)
        self.create_subscription(Twist, 'cmd_vel_teleop', lambda m: self._on_cmd('teleop', m), 10)
        # Two subscriptions: TRANSIENT_LOCAL gets the dashboard's latched value even if we start
        # later; VOLATILE is compatible with plain `ros2 topic pub` from the command line.
        latched = QoSProfile(depth=1, durability=DurabilityPolicy.TRANSIENT_LOCAL,
                             reliability=ReliabilityPolicy.RELIABLE)
        volatile = QoSProfile(depth=1, durability=DurabilityPolicy.VOLATILE,
                              reliability=ReliabilityPolicy.RELIABLE)
        # front docking: the navigator publishes True (4 Hz) while creeping onto the dock
        self.create_subscription(Bool, 'dock_mode', self._on_dock_mode, 10)
        self.dock_until = 0.0
        self.dock_sent = 0.0
        self.dock_on = False
        self.create_subscription(Bool, 'estop', self._on_estop, latched)
        self.create_subscription(Bool, 'estop', self._on_estop, volatile)

        self.create_timer(1.0 / float(g('cmd_rate')), self._send_cmd)
        self.create_timer(0.5, self._publish_status)
        self.create_timer(2.0, self._health_check)

        self.reader = threading.Thread(target=self._reader_loop, daemon=True)
        self.reader.start()
        self.get_logger().info(
            f'esp32_bridge up: r={self.odom.wheel_radius} sep={self.sep} '
            f'ticks L/R={self.odom.ticks_per_rev_left}/{self.odom.ticks_per_rev_right} '
            f'publish_tf={self.publish_tf}')

    # ------------------------------------------------------------------ serial
    def _resolve_port(self):
        if self.port_param != 'auto':
            return self.port_param
        bad = [p for p, t in self.bad_ports.items() if time.monotonic() - t < 60.0]
        port, fallback = pick_esp32_port(list(self.exclude_ports) + bad)
        if port is None and bad:                       # every candidate failed once: start over
            self.bad_ports.clear()
            port, fallback = pick_esp32_port(self.exclude_ports)
        if fallback and not self.warned_fallback:
            self.get_logger().warn(
                f'Guessing ESP32 = {port} (classic ESP32 / USB-UART board), skipping LiDAR port(s) '
                f'{self.exclude_ports}. ttyUSB numbers can swap at boot: install the udev rules '
                '(/dev/esp32) to make this reliable.')
            self.warned_fallback = True
        return port

    def _open(self):
        port = self._resolve_port()
        if not port:
            return False
        s = serial.Serial()
        s.port = port
        s.baudrate = self.baud
        s.timeout = 0.2
        s.write_timeout = 0.1
        # Do NOT toggle DTR/RTS: on the ESP32-S3 USB port that can reset the chip
        # or hold it in the bootloader -> silent port.
        s.dtr = False
        s.rts = False
        s.open()
        s.reset_input_buffer()
        with self.lock:
            self.ser = s
            self.port = port
            self.opened_at = time.monotonic()
            self.odm_since_open = False
        self.get_logger().info(f'Connected to ESP32 on {port} @ {self.baud}')
        # The boot banner was printed before we opened the port; ask the firmware to
        # identify itself so the log shows which version is flashed (v1 ignores this).
        self._write(b'?\n')
        if self.telemetry_on:
            self._write(format_telemetry(True))
        return True

    def _event(self, kind, text):
        with self.lock:
            if kind:
                self.drops[kind] += 1
            self.last_event = (time.monotonic(), text)
        self.get_logger().warn(f'LINK EVENT: {text}')

    def _close(self):
        with self.lock:
            s, self.ser = self.ser, None
        if s:
            try:
                s.close()
            except Exception:
                pass

    def _reader_loop(self):
        warned_missing = False
        while self.running:
            if self.ser is None:
                try:
                    if not self._open():
                        if not warned_missing:
                            self.get_logger().error(
                                'No ESP32 serial port found (tried /dev/esp32, /dev/ttyACM*, /dev/ttyUSB*). '
                                'Is the cable in? GPIO UART: run scripts/setup_pi_uart.sh. Retrying every 2 s.')
                            warned_missing = True
                        time.sleep(2.0)
                        continue
                    warned_missing = False
                except (serial.SerialException, OSError) as e:
                    self.get_logger().error(f'Cannot open ESP32 port: {e}', throttle_duration_sec=10.0)
                    time.sleep(2.0)
                    continue
            try:
                ser = self.ser
                if ser is None:
                    continue
                raw = ser.readline()
            except (serial.SerialException, OSError, TypeError, AttributeError) as e:
                if not self.running:
                    return
                # TypeError/AttributeError: port closed under us by another thread (pyserial fd=None)
                gone = self.port and not os.path.exists(self.port)
                self._event('usb', f'USB serial lost on {self.port} '
                                   f'({"device disappeared: USB disconnect/re-enumeration" if gone else e}); reconnecting')
                self._close()
                time.sleep(1.0)
                continue
            if not raw:
                continue
            try:
                self._handle_line(raw)
            except Exception as e:                       # never let one bad line kill this thread
                if not self.running:
                    return
                self.get_logger().error(f'ESP32 line handling failed: {e!r}', throttle_duration_sec=5.0)

    def _handle_line(self, raw):
        pkt = parse_line(raw.decode('ascii', errors='ignore'))
        if pkt is None:
            self.bad_lines += 1
            return
        if isinstance(pkt, SpdPacket):
            with self.lock:
                self.spd_batch.append([pkt.tl, pkt.ml, pkt.pl, pkt.tr, pkt.mr, pkt.pr])
            return
        if isinstance(pkt, BatPacket):
            with self.lock:
                self.battery = {'v': round(pkt.volts, 3), 'a': None if pkt.amps is None else round(pkt.amps, 3),
                                'src': pkt.src}
                self.last_bat = time.monotonic()
            return
        if isinstance(pkt, BumpPacket):
            with self.lock:
                self.bumper = pkt.pressed
                if pkt.pressed:
                    self.bumps += 1
            if pkt.pressed:
                self.get_logger().warn('bumper pressed: motors stopped by the ESP32')
            return
        if isinstance(pkt, InfoPacket):
            tune = parse_tune(pkt.text)
            if tune:
                self.tune = tune
                return
            if pkt.text.startswith('uptime_s='):
                up = int(pkt.text.split('=', 1)[1] or 0)
                recent = self.last_event and time.monotonic() - self.last_event[0] < 15.0
                if self.drops['usb'] and recent:
                    self._event(None, f'after the USB reconnect the ESP32 has been up {up} s: '
                                      + ('it lost power too (USB/5 V power dip)' if up < 10
                                         else 'it kept running, only the USB link dropped (noise/EMI on USB)'))
                return
            if 'robot_esp32 v' in pkt.text:
                self.fw = pkt.text.split('robot_esp32 v', 1)[1].split()[0]
            if pkt.text.startswith('READY'):
                reason = pkt.text.split('reset=', 1)[1].split()[0] if 'reset=' in pkt.text else '?'
                self.last_reset_reason = reason
                self.guard.reset_totals()                    # its tick totals start again from zero
                if time.monotonic() - self.opened_at > 2.0:   # not just the banner at our own open
                    self._event('resets', f'ESP32 rebooted while running (reset reason: {reason}). '
                                          + RESET_HINTS.get(reason, ''))
                if self.telemetry_on:
                    self._write(format_telemetry(True))      # ESP32 rebooted: turn the stream back on
            self.esp_info = pkt.text
            self.get_logger().info(f'ESP32: {pkt.text}')
            return
        try:
            if isinstance(pkt, ImuPacket):
                self._handle_imu(pkt)
                return
            if isinstance(pkt, UsPacket):
                self._handle_us(pkt)
                return
        except Exception:
            if self.running:
                raise
            return
        self._handle_odom(pkt)

    def _handle_odom(self, pkt: OdomPacket):
        now_t = time.monotonic()
        self.odm_since_open = True
        if self.last_rx and now_t - self.last_rx > 1.0 and now_t - self.opened_at > 2.0:
            self._event('gaps', f'no data from the ESP32 for {now_t - self.last_rx:.1f} s, port stayed open '
                                '(ESP32 busy/reset without banner, USB stall, or this Pi overloaded)')
        if not self.use_imu_yaw:
            pkt.dyaw = None
        clean = self.guard.update(pkt, now_t)
        if clean is None:                                   # faster than the robot can move: a garbled line
            self.get_logger().warn(f'ignored an impossible odometry packet (dl={pkt.dl} dr={pkt.dr} '
                                   f'dt={pkt.dt_ms} ms): serial noise on the ESP32 link',
                                   throttle_duration_sec=5.0)
            with self.lock:
                self.rx_count += 1
                self.last_rx = now_t
            return
        dl, dr, dt, gyro = clean
        with self.lock:
            self.yaw_source = 'gyro' if gyro is not None else 'wheels'
            x, y, th, v, w = self.odom.update(dl, dr, dt, gyro)
            self.rx_count += 1
            self.last_rx = now_t
            self.esp_mode = pkt.mode
        # ESP32 still latched from before a Pi/bridge restart -> show it, require explicit release
        if pkt.mode == MODE_ESTOP and not self.estop and now_t - self.estop_released_at > 1.0:
            self.estop = True
            self.get_logger().warn('ESP32 reports a latched E-STOP. Release it from the dashboard '
                                   '(or publish false on /estop).')
        if not self.running:
            return
        try:
            self._publish_odom(x, y, th, v, w)
        except Exception:            # context shutting down while the reader thread runs
            if self.running:
                raise

    def _handle_imu(self, pkt: ImuPacket):
        self.last_imu = time.monotonic()
        m = Imu()
        m.header.stamp = self.get_clock().now().to_msg()
        m.header.frame_id = 'imu_link'
        m.orientation_covariance[0] = -1.0          # no orientation estimate
        m.angular_velocity.z = pkt.gz
        m.angular_velocity_covariance[8] = 0.0004
        m.linear_acceleration.x, m.linear_acceleration.y, m.linear_acceleration.z = pkt.ax, pkt.ay, pkt.az
        m.linear_acceleration_covariance[0] = m.linear_acceleration_covariance[4] = 0.04
        m.linear_acceleration_covariance[8] = 0.04
        self.imu_pub.publish(m)

    def _handle_us(self, pkt: UsPacket):
        self.last_us = time.monotonic()
        self.us = [pkt.left, pkt.center, pkt.right]
        stamp = self.get_clock().now().to_msg()
        for pub, name, rng in zip(self.range_pubs, ('left', 'center', 'right'), self.us):
            r = Range()
            r.header.stamp = stamp
            r.header.frame_id = f'us_{name}'
            r.radiation_type = Range.ULTRASOUND
            r.field_of_view = 0.26                     # ~15 degrees
            r.min_range = 0.02
            r.max_range = 4.0
            r.range = float(rng) if rng is not None else float('inf')   # inf = nothing in range (REP 117)
            pub.publish(r)

    def _publish_odom(self, x, y, th, v, w):
        stamp = self.get_clock().now().to_msg()
        qx, qy, qz, qw = quaternion_from_yaw(th)

        if self.tf_pub:
            t = TransformStamped()
            t.header.stamp = stamp
            t.header.frame_id = self.odom_frame
            t.child_frame_id = self.base_frame
            t.transform.translation.x = x
            t.transform.translation.y = y
            t.transform.rotation.z = qz
            t.transform.rotation.w = qw
            self.tf_pub.sendTransform(t)

        o = Odometry()
        o.header.stamp = stamp
        o.header.frame_id = self.odom_frame
        o.child_frame_id = self.base_frame
        o.pose.pose.position.x = x
        o.pose.pose.position.y = y
        o.pose.pose.orientation.z = qz
        o.pose.pose.orientation.w = qw
        o.twist.twist.linear.x = v
        o.twist.twist.angular.z = w
        o.pose.covariance[0] = o.pose.covariance[7] = 0.01
        o.pose.covariance[35] = 0.03
        for i in (14, 21, 28):            # z, roll, pitch: not estimated
            o.pose.covariance[i] = 1e6
        o.twist.covariance[0] = 0.01
        o.twist.covariance[35] = 0.03
        self.odom_pub.publish(o)

    def _write(self, data: bytes):
        with self.lock:
            s = self.ser
        if s is None:
            return
        try:
            s.write(data)
        except (serial.SerialException, OSError) as e:
            self.get_logger().warn(f'Serial write failed: {e}', throttle_duration_sec=5.0)

    # ------------------------------------------------------------------ commands
    def _on_cmd(self, source, msg: Twist):
        # a NaN/inf twist (any publisher) would crash format_velocity in the 20 Hz timer: drop it
        if not (math.isfinite(msg.linear.x) and math.isfinite(msg.angular.z)):
            self.get_logger().warn(f'ignored a non-finite {source} command', throttle_duration_sec=5.0)
            return
        self.cmd[source] = (msg, time.monotonic())

    def _on_estop(self, msg: Bool):
        on = bool(msg.data)
        self._write(format_estop(on))          # idempotent on the ESP32, always (re)send
        if on == self.estop:
            return
        self.estop = on
        if not on:
            self.estop_released_at = time.monotonic()
        self.get_logger().warn(f'E-STOP {"ENGAGED (ESP32 latched, RC blocked)" if on else "released"}')

    def _on_dock_mode(self, msg: Bool):
        self.dock_until = time.monotonic() + 1.0 if msg.data else 0.0

    def _dock_refresh(self, now):
        want = now < self.dock_until
        if want and (not self.dock_on or now - self.dock_sent > 0.5):
            self._write(format_dock(True))
            self.dock_sent = now
            if not self.dock_on:
                self.get_logger().info('docking mode ON: ESP32 front stop relaxed at creep speed')
        elif not want and self.dock_on:
            self._write(format_dock(False))
            self.get_logger().info('docking mode OFF')
        self.dock_on = want

    def _send_cmd(self):
        now = time.monotonic()
        self._dock_refresh(now)
        twist, source = None, 'none'
        if not self.estop:
            for src in ('teleop', 'nav'):            # priority order
                msg, t = self.cmd[src]
                if now - t < self.cmd_timeout:
                    twist, source = msg, src
                    break
        self.cmd_source = 'estop' if self.estop else source

        if self.estop:
            self._write(format_estop(True))    # keep the ESP32 latched even if it rebooted
        if twist is None:
            # send a few explicit zeros, then go quiet so the ESP32 drops to IDLE
            if self.zero_frames_left > 0:
                self._write(format_stop())
                self.zero_frames_left -= 1
            self.cmd_out = (0.0, 0.0)
            return

        vl, vr = twist_to_wheels(twist.linear.x, twist.angular.z, self.sep)
        vl, vr = limit_wheels(vl, vr, self.max_wheel)
        self.cmd_out = (twist.linear.x, twist.angular.z)
        self._write(format_velocity(vl, vr))
        self.zero_frames_left = 5

    # ------------------------------------------------------------------ tuning lab
    def _on_esp_cmd(self, msg: String):
        try:
            req = json.loads(msg.data)
            op = req.get('op')
            if op == 'tune':
                cur = dict(self.tune or {k: r[2] for k, r in WHEEL_RANGES.items()})
                cur.update(clamp_values(req.get('values', {}), WHEEL_RANGES))
                self._write(format_tune(cur['kp'], cur['ki'], cur['pwm_min'], cur['max_mms'], cur['accel']))
            elif op == 'save':
                self._write(b'W\n')
            elif op == 'defaults':
                self._write(b'X\n')
            elif op == 'telemetry':
                self.telemetry_on = bool(req.get('on'))
                self._write(format_telemetry(self.telemetry_on))
            elif op == 'query':
                self._write(b'?\n')
            elif op == 'i2c_scan':
                self._write(format_i2c_scan())
            else:
                self.get_logger().warn(f'esp_cmd: unknown op {op!r}')
                return
            self.get_logger().info(f'Tuning Lab -> ESP32: {op}')
        except (ValueError, TypeError, KeyError) as e:
            self.get_logger().warn(f'esp_cmd rejected: {e}')

    def _flush_telemetry(self):
        with self.lock:
            batch, self.spd_batch = self.spd_batch, []
        if batch:
            self.telem_pub.publish(String(data=json.dumps({'s': batch})))

    # ------------------------------------------------------------------ health
    def _health_check(self):
        with self.lock:
            self.rx_hz = self.rx_count / 2.0
            self.rx_count = 0
            connected = self.ser is not None
            age = time.monotonic() - self.last_rx if self.last_rx else float('inf')
        # auto port: opened something that never sends ODM (e.g. the LiDAR's port) -> try another one
        if (connected and self.port_param == 'auto' and not self.odm_since_open
                and time.monotonic() - self.opened_at > 6.0):
            self.get_logger().warn(f'No ESP32 data on {self.port} after 6 s: trying another port')
            self.bad_ports[self.port] = time.monotonic()
            self._close()
            return
        if connected and age > 2.0:
            self.get_logger().warn(
                f'Port {self.port} is open but no ODM data for {age:.0f}s. Check: '
                '(1) firmware v2 flashed, (2) Arduino IDE "USB CDC On Boot" setting, '
                '(3) press the ESP32 RESET button, '
                '(4) run tools/serial_probe.py to see raw output, '
                '(5) GPIO UART (/dev/ttyAMA0): TX/RX crossed, GND joined, Pi serial console off '
                '(scripts/setup_pi_uart.sh).',
                throttle_duration_sec=10.0)

    def _publish_status(self):
        with self.lock:
            age = time.monotonic() - self.last_rx if self.last_rx else None
            st = {
                'connected': self.ser is not None,
                'port': self.port,
                'rx_hz': round(self.rx_hz, 1),
                'rx_age': None if age is None else round(age, 2),
                'esp_mode': MODE_NAMES.get(self.esp_mode, '?'),
                'esp_info': self.esp_info,
                'bad_lines': self.bad_lines,
                'cmd_source': self.cmd_source,
                'cmd_v': round(self.cmd_out[0], 3),
                'cmd_w': round(self.cmd_out[1], 3),
                'estop': self.estop,
                'tune': self.tune,
                'fw': self.fw,
                'telemetry': self.telemetry_on,
                'sep': self.sep,
                'gyro_scale': self.gyro_scale,
                'odom': {'x': round(self.odom.x, 3), 'y': round(self.odom.y, 3),
                         'yaw': round(self.odom.theta, 3),
                         'v': round(self.odom.v, 3), 'w': round(self.odom.w, 3),
                         'turns': round(self.odom.theta_total / (2 * math.pi), 3)},
                'yaw_source': self.yaw_source,
                'odom_guard': dict(self.guard.stats, gyro_bias=round(self.guard.bias, 5)),
                'imu_ok': time.monotonic() - self.last_imu < 1.0,
                'us': ([None if r is None else round(r, 3) for r in self.us]
                       if time.monotonic() - self.last_us < 1.0 else None),
                'battery': (dict(self.battery, fresh=True)
                            if self.battery and time.monotonic() - self.last_bat < 5.0 else None),
                'bumper': self.bumper, 'bumps': self.bumps,
                'drops': dict(self.drops,
                              last=self.last_event[1] if self.last_event else None,
                              last_age=round(time.monotonic() - self.last_event[0]) if self.last_event else None,
                              reset_reason=self.last_reset_reason),
            }
        self.status_pub.publish(String(data=json.dumps(st)))

    def destroy_node(self):
        self.running = False
        self._write(format_stop())
        self._close()
        super().destroy_node()


def main(args=None):
    rclpy.init(args=args)
    node = Esp32Bridge()
    try:
        rclpy.spin(node)
    except KeyboardInterrupt:
        pass
    finally:
        node.destroy_node()
        if rclpy.ok():
            rclpy.shutdown()


if __name__ == '__main__':
    main()
