ArpitAwasthi2411/slam-robot/(commit log)

2026-10-06 SLAM robot v0.2: firmware v2.1, goal controller, web dashboard
    Fixes the silent ESP32 serial link (USB CDC routing, no DTR/RTS toggling),
    moves the ROS package to ament_python, splits Cartographer configs for
    odometry and LiDAR-only modes, and adds RViz-goal driving, a web teleop
    dashboard, an ESP32 e-stop latch, field tools and docs.
2026-10-06 Support classic ESP32 alongside ESP32-S3
    Firmware picks a safe pin map per chip (classic avoids flash pins 6-11 and
    strapping pins). The bridge and serial probe find a /dev/ttyUSB* ESP32
    without grabbing the LiDAR port; udev rules document CH340 vs CP2102 setups.
2026-10-06 Add RC calibration readout (firmware C command, serial_probe --rc)
2026-10-07 Firmware v2.2 + Pi support: MPU-6050 gyro, 3x HC-SR04, e-stop button
    Gyro yaw is integrated on the ESP32 and used for odometry heading (wheels
    keep distance). Ultrasonics are interrupt-driven, feed front clearance and
    replanning on the Pi, and give the ESP32 its own 15 cm forward block in
    AUTO. The mushroom e-stop cuts the driver enables in hardware and latches
    E-STOP in firmware. Includes wiring/mounting guide and tests.
2026-10-07 Classic-ESP32-only firmware v2.2 and complete wiring list
2026-10-07 Add rc_reader sketch for manual RC calibration
2026-10-07 RC calibration from measured values; swap RC pins; steering reverse
2026-10-07 Step-by-step guide for classic ESP32, setup_ports.sh, lidar_port default /dev/rplidar
2026-10-07 Fix P command: constrain() macro evaluated parseLong() 3 times, raw PWM was always 0
2026-10-07 Calibrated directions, PWM_MIN/MAX speed, ticks_per_rev from hardware tests
2026-10-08 Day 2 guide: power-on to autonomous driving
2026-10-08 Cartographer: trust LiDAR over wheels for rotation, wider angular search, smaller free-space rays
2026-10-08 LiDAR is 13 cm behind the drive axle: laser_x default -0.13
2026-10-08 find_ports.py: identify ESP32 vs LiDAR by listening for ODM lines (socket-independent)
2026-10-08 Tuning Lab back-end: bridge esp_cmd + wheel telemetry, live follower tuning, step/spin tests, CORS + /api/ping/esp/telemetry/test, simulator wheel model, tests
2026-10-08 Pathik mobile app: drive, places & missions, Tuning Lab (wheel PID, path follower, step/straight/spin tests), status; served at / by the robot
2026-10-09 Start guide: fixes for no internet on the Pi, laptop internet sharing over the cable
2026-10-09 Find ESP32 and LiDAR ports automatically at every launch (by the data they send), any USB socket
2026-10-09 Navigator: pose = SLAM correction (may lag) composed with fresh wheel odometry; service reads launch args from ~/robot.env
2026-10-13 v2.4 navigation: real body shape (rectangle, axle at front) in planning and driving, 3-point turns, battery + dock, schedules, wait-for-OK, mission log, rooms, explain
2026-10-13 Pathik app v2.4: battery chip, why?, wait-for-OK card, Room tool + rooms list, charging dock, schedules, mission log + CSV; MCP server; firmware v2.4 (INA226, bumpers); dock + battery guide
2026-10-21 Ultrasonic mount default us_x 0.07 (front bumper is 7 cm ahead of the axle)
2026-10-22 Bridge: if the auto-picked port never sends ODM, try the next one; don't let a stale /dev/rplidar link hide the ESP32; 6 s port detection
2026-10-22 Fix 'position lost' while planning: TF listeners in their own thread, SLAM pose at 50 Hz instead of 200 Hz, short pose gaps pause instead of re-planning
2026-10-22 Wiring doc: v2.4, Pi connections, battery/dock section
2026-10-22 Diagnose motor-board/app drops: classify USB loss, ESP32 reboot (with reset reason) and data gaps; harden bridge reader thread; link_doctor tool
    - firmware: READY line carries esp_reset_reason (BROWNOUT/POWERON/EXT/WDT...), '?' reports uptime
    - esp32_bridge: LINK EVENT log lines + status 'drops' counters; reader thread survives bad lines and
    a port closed under it (previously could die silently -> permanent 0 Hz)
    - dashboard: bridge considered alive for 3 s (was 1.5 s) so a busy Pi doesn't flash 'not talking'
    - app Status: 'Link drops' row
    - tools/link_doctor.sh: check / --watch while driving / --fix (Wi-Fi power save off, ModemManager/brltty)
    - wiring doc: troubleshooting table, USB power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
2026-10-23 Docker image + CI/CD: tests, multi-arch build (Pi arm64 + amd64), push to GHCR, Pi update with auto-rollback
    - Dockerfile: ROS 2 Humble base -> sllidar_ros2 (source) -> lidar_robot; test stage runs the unit tests
    inside the image; runtime stage with healthcheck (/api/ping), version label, /root/maps volume
    - deploy/pi/docker-compose.yml: host network (DDS + app), /dev + cgroup rules so USB serial ports survive
    reconnects, maps volume, log size limits, restart policy, clean SIGINT stop
    - scripts/pathik.sh: install / update (waits for healthy, rolls back by itself) / rollback / use <tag> / users
    - .github/workflows/robot-image.yml: test -> image (tests in image, smoke test, push latest/sha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
2026-10-24 ESP32-S3 firmware v2.5 (port of classic v2.4 + RGB status LED) and firmware compile CI
    - firmware/robot_esp32s3: native USB link (/dev/ttyACM0, cannot be confused with the LiDAR),
    S3 pin map avoiding straps/USB/flash/PSRAM pins, battery ADC on ADC1 (GPIO 1), bumper with
    internal pull-up, RGB LED states (rainbow while driving, speed-scaled), L,r,g,b,ms command
    - .github/workflows/firmware.yml: compiles classic + S3 sketches on core 2.0.17 and 3.0.7
2026-10-24 ESP32-S3 wiring guide: pin table, level-shifter rules, power, Pi side, first power-up checks
2026-10-26 find_ports: recognise the ESP32-S3 (/dev/ttyACM*) next to the LiDAR (/dev/ttyUSB*)
2026-10-26 Lab kit for the ESP32-S3: full connection list, step-by-step lab guide, CLAUDE.md project memory
2026-10-28 ESP32-S3 <-> Pi over the GPIO UART (Pi pins 6/8/10), ESP32 powered from the buck
    Firmware v2.6: Pi link on UART1 (ESP TX 47 -> Pi pin 10, ESP RX 8 <- Pi pin 8),
    output echoed to the USB socket for the laptop Serial Monitor, separate line
    buffers per source, only well-formed command lines accepted (console/boot
    text on the UART can't trigger E/R/S).
    Pi: scripts/setup_pi_uart.sh (enable_uart + disable-bt, serial console and
    getty off, udev /dev/esp32 -> /dev/ttyAMA0); find_ports, ports.detect_ports,
    serial_probe and link_doctor know the GPIO UART. Docs: connections, wiring,
    lab steps, CLAUDE.md.
2026-10-28 Fix 'position lost' pauses: Cartographer on 2 cores, no new nodes while standing still; slower turns
    Cartographer used 4 background + 4 solver threads on the Pi's 4 cores and added a
    node every 0.5 s even when the robot stood still, so the pose graph and CPU load
    grew all the time: the bridge/navigator (Python) lagged, odometry TF went stale and
    the navigator paused with 'position lost'. Now 2+2 threads, motion_filter max_time
    5 s, occupancy grid every 2 s, pose_timeout 1.5 s. Turns slower than driving
    (navigator 0.30 rad/s, accel 0.4; joystick 0.40 rad/s) for a steadier map.
    tools/robot_check.sh: one-shot heat/power/CPU/topic-rate/link-event check.
2026-10-28 vision/robot_decision.py: camera -> STOP/SLOW_DOWN/CONTINUE (YOLO rules every frame + Groq every 5 s, careful one wins), with tests
2026-10-28 Camera people avoidance: vision node (Camera Module 3, YOLO11n NCNN, LiDAR distance), navigator slows/stops, app camera card
    - vision_node.py: libcamera via a gst-launch subprocess (no OpenCV GStreamer build needed) or a USB
    webcam; YOLO11n on NCNN (no PyTorch at run time, 2 threads, ~4 Hz, nice 5); PersonTracker for
    ids/approaching; each person's distance from the LiDAR scan at its bearing; publishes
    /vision/decision (JSON) and /vision/image/compressed (annotated JPEG, 5 Hz).
    - vision_rules.py: YOLO decode + NMS, tracker, bearing, LiDAR lookup, STOP/SLOW_DOWN/CONTINUE rules,
    VisionGate (fresh decisions only, forward motion only; stale/no camera = no effect).
    - navigator: applies the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
2026-10-28 Camera Module 3 on Ubuntu 22.04: build the imx708 + dw9817 drivers (no Ubuntu kernel has them)
    Checked the linux-modules-5.15.0-1108/1110-raspi packages: only imx219/imx477, no imx708 and no
    dw9807-vcm, so 'update the kernel' could never help. scripts/setup_imx708_driver.sh builds
    imx708.c + dw9807-vcm.c from raspberrypi/linux rpi-5.15.y (pinned commit) with DKMS (rebuilt on
    kernel updates) and installs imx708.dtbo + dtoverlay=imx708. Both modules cross-compile cleanly
    against linux-headers-5.15.0-1108-raspi; every overlay label exists in Ubuntu's bcm2711-rpi-4-b.dtb
    (i2c_vc only for the cam0 override, same as Ubuntu's imx219 overlay).
    setup_pi_camera.sh: checks internet first, runs the driv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
2026-10-29 docs/CLOUD_SESSION_PROMPT.md: next cloud session plan (review, remote control, app redesign, LLM recovery, front docking, voice, URDF)
2026-10-29 Phase 0: repo review fixes (docs/REVIEW_2026-10.md)
    Bugs: non-finite drive/goal numbers rejected at HTTP (400), ignored by the dashboard and dropped by the
    bridge (a NaN twist crashed format_velocity in the 20 Hz timer); the 'stop' command also ends Map by
    itself; auto-home and explain() can no longer raise out of the control loop; setup_ports.sh works with
    the ESP32 on the GPIO UART (only names the LiDAR, never touches /dev/esp32); serial_probe uses the
    measured 4970 ticks/rev and the current sketches; shellcheck directive in the Docker entrypoint.
    Docs: S3 + classic pin tables in hardware/README, sensors.md and wiring_classic_esp32.md now match the
    sketches (classic RC 35/34); README hardw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
2026-10-29 Phase 1: remote control from another network
    - setup_tailscale.sh: TS_AUTHKEY from env or ~/robot.env (never printed), starts on boot,
    status check, optional Funnel (needs an admin account first) with ~/maps/.public_url flag
    - dashboard: knows LAN / Tailscale / public Funnel requests (net info in /api/ping and
    /api/state), HSTS + security headers, public API refused without logins
    - auth: per-address and public per-account login limits, sign-up caps, no first admin
    over the public link, 7-day public sessions
    - app: path tag (PUBLIC in red), Me warning card, joystick pauses above 600 ms / 1.5 s
    without an answer and never queues commands, https/Funnel addresses
    - setup_wifi.sh: hotspo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
2026-10-29 Phase 2: app redesign without losing a feature
    - docs/APP_FEATURES.md: inventory of every screen, button, tool, test, endpoint and demo behaviour
    (106 rows) with roles, each mapped to where it lives now
    - new layout: Home (status card, mission, Send or call, quick actions, camera, charging), Send (command /
    voice with plan preview, places, rooms, scheduled trips), Map (map + shrinkable sheet), Drive, Operate hub
    (Health, Wheel tuning, Path following, Drive tests, Mission log, People, settings); staff: Home Send Map Me
    - STOP docked in the middle of the tab bar on every screen; alerts stack under the top bar on every tab
    - added: inline route preview + Show on map, delete place (operato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
2026-10-29 Phase 3: LLM error recovery with a fixed safe-action menu
    - recovery.py: menu (wait_retry, replan_wide, alt_route, skip_stop, reorder, ask_person, go_home, go_dock),
    allowed actions per situation, JSON validation + clamping, rule-based escalation ladder, Groq LLM client
    (configurable model) run in a thread with timeout; any LLM problem -> rules, and the reason is recorded
    - navigator_core: failures with a recoverable code stop the robot (RECOVERING), build the context (failure,
    stop, mission, queue, battery, time, room, history of the place, detour candidates), apply the decision,
    track the outcome; recovery_answer request (staff may answer); e-stop / cancel end a recovery
    - mission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
2026-10-29 Phase 4: front docking with the ArUco marker + firmware docking mode
    - docking.py: FrontDocker (align with search sweep, creep <= 5 cm/s with pure pursuit on the dock line,
    blind contact with odometry heading hold, contact = charging current or voltage rise, back off + retry,
    DOCK_NO_MARKER / DOCK_NO_CONTACT to error recovery), marker geometry, map-fused heading, synthetic camera
    - marker_pose.py: detect(frame) -> {found, x_m, y_m, z_m, yaw_deg} (Neelaksh's interface), OpenCV 4.5 and
    4.7+ ArUco APIs, PnP candidate with the best reprojection (planar ambiguity), calibration YAML with
    Camera Module 3 Wide defaults for 640x480 and 640x360
    - navigator: pre-dock pose in front of the dock,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
2026-10-29 Phase 5: voice - push-to-talk, Groq Whisper / Vosk, Piper TTS
    - voice.py: WAV read (8/16-bit, stereo), resample to 16 kHz, silence trim + too-quiet / too-short checks,
    multipart upload, GroqWhisper (whisper-large-v3-turbo), VoskSTT (English + Hindi, most confident wins),
    SpeechToText online-first with offline fallback and clear errors, VoiceAssistant (wav -> text -> command ->
    spoken reply), PushToTalk (debounce, max length, app button), GpioButton (libgpiod v1/v2)
    - voice_node.py: GPIO17 button (pin 11, GND pin 9) and /voice/control from the app, arecord, beep, reply
    through /speech/say, /voice/status for the app
    - speech.py: Piper (offline, EN voice + Hindi voice for Devanagari), e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
2026-10-29 Phase 6: Xacro URDF + robot_state_publisher instead of the static TFs
    - urdf/pathik.urdf.xacro: base_link body box from the navigator footprint, wheels at +-wheel_separation/2,
    caster, laser, camera_link + camera_optical_frame (docking camera mount), imu_link, us_left/center/right;
    same frame names and offsets as the old static_transform_publishers, all numbers from the launch args
    and config/robot_params.yaml
    - bringup: robot_state_publisher with the rendered model (urdf:=true default); urdf:=false = the old
    static publishers
    - urdf_model.py: real xacro when installed, else a small renderer for the subset the file uses; frames()
    and launch_args_from_params() for checks
    - RViz Robo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
2026-10-29 Wrap-up: README feature list, docs/KEYS.md (every key and account), CLAUDE.md
    - README: intro, feature table (remote control, recovery, docking, voice, URDF), layout with the new
    modules, links to the phase docs, status list, test commands (eval_recovery, app parity)
    - docs/KEYS.md: each ~/robot.env line (GROQ_API_KEY, TS_AUTHKEY, ROBOT_ARGS, ROBOT_USER/PASSWORD,
    PATHIK_PORT), what works without it, accounts (Pathik admin, Tailscale, GitHub/GHCR, keystore secrets),
    one-time downloads
    - CLAUDE.md status pointers + session log; WORK_LEFT B5 points to KEYS.md
2026-10-29 Robot voice button: trips only from the home spot, stop/OK anywhere, admin switch; network loss: finish accepted trips, then wait at home
2026-10-30 setup_vision: CPU-only PyTorch for the one-time model export (avoids ~3 GB of CUDA wheels on the Pi)
2026-10-30 setup_vision: on a Pi 4 export the YOLO model on the laptop (PyTorch ARM wheels crash with Illegal instruction)
2026-10-30 Lighter on a Pi 4: camera picture streamed only while the app's camera view is open, YOLO 1 thread at 2 Hz, voice button polled at 20 Hz
2026-10-30 Lighter on the Pi 4: frozen map in localization, CPU plan, numpy scan code, camera at 5 frames/s, marker search only while docking, Pi health in the app
    - localization: occupancy grid from the saved map only (-include_unfrozen_submaps false, every 10 s):
    costmap built once, people are never painted into the map as walls
    - launch cpu_plan (cpu_plan.py): vision on core 3 at nice 10; dashboard, voice, map drawing nice 5
    - Cartographer map->odom at 20 Hz (was 50); localization submap list every 1 s
    - scan_points.py: numpy front clearance / obstacle points / app points (same results as the old loops)
    - dashboard: scan points only when an app asks, state built at most every 0.1 s, numpy map byte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
2026-10-30 Restore the simulator's sample schedules (a local sim run had changed them)
2026-10-30 Accurate floor maps: corridor-safe Cartographer settings, offline high-quality rebuild, gyro scale calibration
    - cartographer_odom.lua: trust good odometry along corridors (no online correlative search, ceres
    translation 20 / rotation 40, odometry weights 1e5), bigger submaps, 10 m range, stricter loop closures
    - scripts/map_offline.sh: record the mapping drive (/scan /odom /imu /tf_static + the URDF), rebuild it with
    cartographer_mapping_hq.lua (4 threads, more loop closures, long final optimisation) -> .pbstream + .pgm
    - esp32_bridge gyro_scale; the app's Spin test calibrates it when the heading comes from the gyro
    - serial_probe --push --metres 5
    - docs/mapping.md: calibration, how to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
2026-10-31 Phone detector (lab): YOLO11n people detection running on the phone, same rules as the robot
    - web/app/detect.html + detect.js: phone camera (or the robot's camera picture) -> YOLO11n 320 px on
    ONNX Runtime Web -> boxes, bearing, camera distance estimate, STOP / SLOW DOWN / CONTINUE, ms and fps
    - web/app/vision.js: JavaScript port of vision_rules.py (letterbox, decode + NMS, tracker, decide);
    test_phone_detector.py runs it in Node against the Python on random inputs
    - Android: CAMERA permission, the page is served from https://appassets.androidplatform.net (secure origin,
    COOP/COEP for multi-threaded WebAssembly), openDetector/closeDetector bridge
    - Operate -> Phone detector entry; doc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
2026-10-31 Head mode: the phone on the robot is its face, PIN kiosk and people detector
    Phone (web/app):
    - head.html + head.js: face with 11 moods from the robot's state (face.js), STOP without PIN, OK and
    error-recovery answers, PIN-protected kiosk (places, rooms, typed/spoken command, go home, cancel),
    settings (PIN, release STOP, leave), demo robot + phone-camera detection test when not connected
    - detector.js: the YOLO11n / ONNX Runtime Web detector and picture sources, shared with the lab page
    - Operate -> Head mode; Android openHead (same secure asset origin as the detector)
    Robot:
    - vision node: plain JPEG on request (vision/raw_request -> vision/raw/compressed), people boxes from the
    pho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
2026-10-31 Phone detector: native TensorFlow Lite engine on the GPU / all CPU cores
    The web engine (ONNX Runtime Web) gets one thread inside an Android WebView
    (~180 ms per frame). The app now runs YOLO11n 320 natively:
    - NativeDetector.java: TFLite 2.16.1, GPU delegate and XNNPACK (cores-1
    threads) both timed at start, the faster is kept; boxes in 320 px space
    - MainActivity bridge detectorInit / detect / hasNativeDetector on a worker
    thread, results to window.__pathikDetDone(id, json)
    - detector.js: native first, ONNX Runtime Web as fallback; the page shows
    the engine and both start-test times
    - fetch_phone_detector.sh converts the same ONNX with onnx2tf (fp16);
    scripts/check_phone_model.py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
2026-10-31 Tests: skip the Android wiring checks inside the robot image (only the ROS package is there)
2026-11-01 Head mode: greeting, errands, camera door check; peak test; better person tracking
    - First touch says "Hi, I'm Pathik! Where would you like to go?" on the robot's
    speaker (new navigator {type: say}); places confirmed aloud
    - Errands from the kiosk (mission.js): go to a place, check its door, say a
    message, wait N s or until OK, come back to the start pose / home / stay,
    spoken report; demo robot supports it
    - Door check with the camera (doorcheck.js): teach each door closed/open in
    head settings; layout + edge-direction signature, shift and light tolerant
    - Peak test page (peak.html): detection flat out + face + door checks + speech
    for 1-20 min, live charts, pass/fail (peakcheck.j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
2026-11-01 Peak test: tracked people with ids drawn with their picture (no flicker), GPU/CPU start test + ids in the shared result; native JPEG encode off the page thread
2026-11-01 deviceStats: app memory from /proc/self/statm (Debug.getMemoryInfo blocked the page 50+ ms, counted as stalls)
2026-11-01 Wheel ticks from the 31 Oct 5 m drive (5048/5063) into the repo config
2026-11-02 LiDAR measured 14 cm behind the axle: laser_x default -0.14
2026-11-02 Remember ultrasonic-only blockers for replans; wait blocked_after 5 s before replanning
2026-11-02 Ultrasonic blocker: side-aware outline from all three sensors, keeps growing while going round, skips mapped walls
2026-11-10 LLM fix: gpt-oss models, User-Agent, error classes, smart policy, schema guards, AI debug page
    - Groq retired llama-3.1-8b-instant / llama-3.3-70b-versatile (16 Aug 2026): default openai/gpt-oss-20b
    for commands and openai/gpt-oss-120b for recovery; old names remapped, runtime fallback model
    - Send a User-Agent (Cloudflare 1010 blocked Python-urllib) for chat, models and Whisper
    - llm.py: GroqClient with classified errors + fix hints, strict json_schema (place enum), LLMLog, diagnose()
    - commands: llm_policy smart|always|off, stop never sent, preview/send cache, urgent clamp,
    LLM unknown never overrides rules
    - navigator parses in a worker thread outside the core lock; longer dashboard/a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
2026-11-10 Conversation agent with a college notebook; odometry guard and map displacement fixes
    Conversation (docs/chat.md)
    - chat.py: questions go to a conversation agent instead of the command path ("library timings?" no longer
    drives). One strict-JSON model call with the notebook, the places, the robot's state and the last turns;
    optional second lookup; follow-ups like "take me there" become trips checked by CommandParser.build
    - guards: sources limited to the entries shown, numbers must be in the notes, places are an enum,
    urgent only with urgent words, plain short replies, offline notebook read-out when the model fails
    - knowledge.py: notebook in ~/maps/knowledge.json, weighted word search,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
2026-11-11 Nav2 as a switchable navigation backend (nav_mode:=nav2)
    - nav2_follower.py: Nav2 behind the follower interface. NavigateToPose (or FollowPath with Pathik's route);
    Nav2's command passes Pathik's front-clearance, body and speed checks before it reaches the motors;
    Nav2 abort or a held robot -> BLOCKED -> the usual replans and recovery
    - navigator: action clients, cmd_vel_nav2 and /plan subscriptions; falls back to the built-in planner
    when Nav2 is not installed
    - launch: controller, planner, behavior servers + bt_navigator + lifecycle manager, cmd_vel remapped
    - config/nav2_params.yaml for the Pi 4 (NavFn, Regulated Pure Pursuit, small costmaps)
    - scripts/setup_nav2.sh, docs/nav2.md, t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
2026-11-14 Head-mode kiosk rework (PIN last, side icons, new face) and person-or-object blocker
    Kiosk (head.html, head.js, face.js)
    - Go / Ask / Deliver icons at the sides of the face; the PIN is asked last, just before the robot starts
    (or a trip is cancelled). Questions never need it
    - Ask: questions answered on screen and by the robot's voice; a trip asked for in words is shown, then the PIN
    - tapping the face makes the robot introduce itself (one line per tap); while busy it says what it is doing
    - new face: visor, glowing eyes, moods ease into each other, glances, talking mouth, attention ring
    - PIN pad fits a sideways phone; STOP stays above every sheet
    Person or object in the way (blockers.py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
